luofanzhi/NB_DATA_COLLECT/README.md

# NB_DATA_COLLECT
NB-IOT水表收集器

## git使用指南

### 第一次初始化项目

```bash
git clone 项目地址
```

### 提交代码

```bash
# 拉取GitHub上最新的代码信息
git pull

# 选中本地修改的文件
git add .

# 提交变动到本地
git commit -m "注释信息"

# 推送到服务器
git push
```
