luofanzhi/NB_DATA_COLLECT/附件材料.docx

毕业设计（论文）附件材料

基于蓝牙和NB-IOT的数据采集器设计

学生姓名： 罗范支

学 号： 201610213116

所在系部： 电气信息系

专业班级： 16 gb电气3班

指导教师： 李 群 教授（职称）

日 期： 二O二O年5月

# 目 录

# 图表目录

# 第1章 程序源码

## main.c

#include "Systerm_Init.h"

#include "stm32f10x_it.h"

#include "oled.h"

#include "stdlib.h"

#include "delay.h"

#include "beep.h"

#define Scan_min(n) 60000*n //定时扫描事件

int main(void)

{

SystemInit(); //系统时钟初始化

SYSTERM_INIT(); //系统初始化

OLED_Init(); //OLED初始化

OLED_ColorTurn(0); //0正常显示，1- 反色显示

OLED_DisplayTurn(0); //0正常显示，1-屏幕翻转显示

OLED_Clear(); //清屏

BLUE_POWER_OPEN(); //打开蓝牙电源

Deveice_Display(); //设备信息显示

BlueConnectStruct.Connect=0;

while(1)

{

NB_INIT(); //上电初始化NB，储存EMI号和信号强度

KEY_Set_Blue_S_Mode(); //短按按键蓝牙切换成从模式和APP通讯

APP_To_BlueScan(Scan_min(5)); //APP启动扫描, 计时扫描单位：分钟

Determine_Deveice(); //APP通讯错误信息返回

JZQ_Write_NAME_MAC(); //APP写表号

NB_UPDATE_DATA(); //NB上传表数据--最大上传40个蓝牙水表

//Wake_Deal(); //定时唤醒处理

if(BlueConnectStruct.Connect==1)

{

if(BLUE_CONNECT_COND==0)

{

OLED_Display_GB2312_string(1,6,"蓝牙等待连接...");

}

if(BLUE_CONNECT_COND==1)

{

OLED_Display_GB2312_string(1,6,"蓝牙已连接！！！");

BlueConnectStruct.Connect=2;

}

}

else if(BlueConnectStruct.Connect==2)

{

if(BLUE_CONNECT_COND==0)

{

BlueConnectStruct.Connect=1;

}

}

}

}

## Systerm_Init.c

#include "Systerm_Init.h"

#include "beep.h"

#include "oled.h"

void SYSTERM_INIT(void)

{

NVIC_PriorityGroupConfig(NVIC_PriorityGroup_2); //中断优先级分组

USART1_Init(9600); //NB的串口

USART2_Init(115200); //蓝牙串口

USART3_Init(115200); //DEBUG串口

TIM3_Init(99,4799);//10K的计数频率，重装值为100

TIM4_Init(99,479);//1ms

delay_init();

LED_GPIO_Init();

KEY_GPIO_Init();

NB_GPIO_Init();

BLUE_GPIO_Init();

LED_Init();

NB_ALL_Flag_Init();

//IWDG_Init(6,28125);//独立看门狗初始化-预分频系数为64，重载值为625，溢出时间为1S //(4*2^5)*31250/40 ms

RTC_Init();

RTC_NVIC_Config();

ConnectBlueStruct.Connect_quality=20;//连接表端的结点数

Read_NAME_AND_NAME();//读取缓存的表号和MAC地址

BEEP_GPIO_Init();

PrintfFlag=1;

ReceivMAC_Flag=0;

}

void LED_Init(void)

{

LEDn_ON(4);

delay_ms(1000);

LEDn_OFF(4);

}

void NB_ALL_Flag_Init(void)

{

NB_Flag_Init();

Blue_Flag_Init();

BlueConnectStruct.BlueConnect_time=0;

BlueDataRceiveModeStruct.DataMode.Start_NB=0;

NB_AT_Num=0;

BlueDataRceiveModeStruct.Blue_AT_Mode=0;

BlueDataRceiveModeStruct.Blue_Data_Mode=0;

ConnectBlueStruct.Connect_Number=0;

ConnectBlueStruct.ReadBlueData_Success=0;

BlueDataRceiveModeStruct.DataMode.BlueDataCount=0;

ConnectBlueStruct.StopScan=0;

ConnectBlueStruct.Connect_OverTime_Flag=0;

ConnectBlueStruct.ReadBlueData_fail=0;

FLASH_Struct.Write_Success=0;

k=0;

Sleep_Mode_Struct.Enter_SleepMode_Flag=0;

Sleep_Mode_Struct.WeakUP=0;

BlueDataRceiveModeStruct.Blue_To_APP=0;

CommunicationStruct.Communication_RX_Cont=0;

CommunicationStruct.APP_To_JQZ_CB_Flag=0;

NB_Struct.NB_Init=0;

Work_Struct.Mode_type.JQZ_Mode.Update=0;

Work_Struct.Mode_type.Weakup.Set_ARM_Time=0;

Work_Struct.Mode_type.Weakup.WeakUP_Over_Time=0;

Work_Struct.Mode_type.Sleep_Mode=0;

Work_Struct.Mode_type.Blue_S.Con_over_Time=0;

CommunicationStruct.APP_To_JQZ_CB_Flag=0;

CommunicationStruct.JQZ_CB_UPDATE=0;

NB_Struct.NB_1=1;

NB_Struct.Net_time=0;

}

void Deveice_Display(void)

{

OLED_Display_GB2312_string(1,0,"湖北工业大学");

OLED_Display_GB2312_string(1,2,"工程技术学院");

OLED_Display_GB2312_string(1,4,"姓名：罗范支");

OLED_Display_GB2312_string(1,6,"学号201610213116");

delay_s(2);

OLED_Clear();

OLED_Display_GB2312_string(1,0,"毕业设计题目：");

OLED_Display_GB2312_string(1,2,"基于蓝牙和NB模组");

OLED_Display_GB2312_string(1,4,"的数据收集器");

OLED_Display_GB2312_string(1,6,"指导老师：李群");

delay_s(2);

OLED_Clear();

OLED_Display_GB2312_string(1,0,"系统初始化...");

BEEP_ON(1);

}

## NB.c

#include "NB.h"

#include "usart.h"

#include "string.h"

#include "led.h"

#include "BlueData_Deal.h"

#include "SimplePrintf.h"

#include "delay.h"

#include "communication_to_app.h"

#include "flash.h"

#include "wakeup.h"

#include "oled.h"

#include "beep.h"

u16 NB_time;

u8 NB_SendData_flag;

u8 NB_ReceveData_flag;

u8 NB_AT_Num;

u8 NB_ReceveData_Failed_Flag;

u16 NB_Close_Power_time;

NB_Typedef NB_Struct;

char Device_information_char_Buff[50];

uint8_t Device_information_u8_Buff[50];

//NB模组IO口初始化

void NB_GPIO_Init(void)

{

GPIO_InitTypeDef GPIO_InitStructure;

RCC_APB2PeriphClockCmd(RCC_APB2Periph_GPIOA,ENABLE);

GPIO_InitStructure.GPIO_Mode =GPIO_Mode_Out_PP;

GPIO_InitStructure.GPIO_Pin =GPIO_Pin_8|GPIO_Pin_12;

GPIO_InitStructure.GPIO_Speed = GPIO_Speed_2MHz;

GPIO_Init(GPIOA,&GPIO_InitStructure);

GPIO_ResetBits(GPIOA,GPIO_Pin_8|GPIO_Pin_12);

//GPIO_SetBits

//GPIO_ResetBits

}

void NB_NO_Rest()

{

NB_Switch=0;

}

void NB_Rest()

{

NB_Switch=1;

}

#include "time.h"

u8 CurrentTim[6];//年，月，日，时，分。各一个字节

struct tm GTM_Time;

void GTM_ConversionUTC(uint16_t Count)

{

static u32 TimSec;

GTM_Time.tm_year = 2000+CurrentTim[0]-1900;//年

GTM_Time.tm_mon = CurrentTim[1]-1;//月

GTM_Time.tm_mday = CurrentTim[2];//日

GTM_Time.tm_hour = CurrentTim[3];//时

GTM_Time.tm_min = CurrentTim[4];//分

GTM_Time.tm_sec = CurrentTim[5];//秒

TimSec = mktime(&GTM_Time);

TimSec += Count;

localtime_r(&TimSec, &GTM_Time);

CurrentTim[0] = GTM_Time.tm_year+1900-2000 ;//年

CurrentTim[1]= GTM_Time.tm_mon+1 ;//月

CurrentTim[2]= GTM_Time.tm_mday ;//日

CurrentTim[3] = GTM_Time.tm_hour ;//时

CurrentTim[4]= GTM_Time.tm_min ;//分

CurrentTim[5] = GTM_Time.tm_sec ;//秒

}

/************************NB上传数据函数*********************************/

void NB_Update_Data(void)

{

char cmd[129];

strcpy(cmd, "AT+NMGS=59,");

strcat(cmd,BlueDataRceiveModeStruct.DataMode.BlueDataStringBuff);

memset(BlueDataRceiveModeStruct.DataMode.BlueDataStringBuff,0,sizeof(BlueDataRceiveModeStruct.DataMode.BlueDataStringBuff));

memset(BlueDataRceiveModeStruct.DataMode.BlueDataStringBuff,0,sizeof(BlueDataRceiveModeStruct.DataMode.BlueDataStringBuff));

Uart1_SendAtCommand(cmd);

}

void NB_Flag_Init(void)

{

NB_AT_Num =0;

NB_SendData_flag =1;

NB_ReceveData_flag=1;

NB_Close_Power_time=0;

}

uint8_t NB_Bard_AT_Send(u8 a)

{

uint8_t m,n;

static char temp[12];

static char i;

static char IP[40];

STMFLASH_Read(FLASH_SAVE_ADDR+2048,(u16*)CommunicationStruct.IP_COM_u8,20);

HEXArrayToStringArray((u8*)CommunicationStruct.IP_COM_u8,CommunicationStruct.IP_COM_char,20);

StringArrayToHEXArray(CommunicationStruct.IP_COM_char,CommunicationStruct.IP_COM_string,40);

strcpy(IP,"AT+NCDP=");

for(i=0;i<15;i++){IP[i+8]=CommunicationStruct.IP_COM_string[i+5];}

IP[23]=CommunicationStruct.IP_COM_string[4];

IP[24]=CommunicationStruct.IP_COM_string[0];

IP[25]=CommunicationStruct.IP_COM_string[1];

IP[26]=CommunicationStruct.IP_COM_string[2];

IP[27]=CommunicationStruct.IP_COM_string[3];

if(NB_SendData_flag)

{

NB_SendData_flag=0;

switch(NB_AT_Num)

{

case 0: NB_Power_Control=1;// 1-开启NB电源，0-关闭NB电源

//NB_Rest();

NB_time=50;

break;

case 1: USart_CLR_RecvBuf(1);

Uart1_SendAtCommand("AT");//测试AT命令

NB_time=50;

break;

case 2:

if(strstr(USART1_RX_Buff,"")!=NULL)

{

USart_CLR_RecvBuf(1);

NB_ReceveData_Failed_Flag=0;

Uart1_SendAtCommand("AT+NCDP=180.101.147.115,5683");//设置IoT平台IP地址

//Uart1_SendAtCommand(IP);//设置IoT平台IP地址

NB_time=50;

}

break;

case 3:

if(strstr(USART1_RX_Buff,"")!=NULL)

{

USart_CLR_RecvBuf(1);

Uart1_SendAtCommand("AT+CGMR");//查询固件版本

NB_time=50;

}

break;

case 4: if(strstr(USART1_RX_Buff,"")!=NULL)//SECURITY

{

USart_CLR_RecvBuf(1);

Uart1_SendAtCommand("AT+CGSN=1");//查询IMEI号

NB_time=100;

}

break;

case 5: if(strstr(USART1_RX_Buff,"+CGSN:")!=NULL)

{

for(m=0;m<50;m++)

{

if(USART1_RX_Buff[m-2]=='N'&&USART1_RX_Buff[m-1]==':')

{

for(n=0;n<15;n++){Device_information_char_Buff[n]=USART1_RX_Buff[n+m];}

Device_information_char_Buff[15]='0';

}

}

USart_CLR_RecvBuf(1);

Uart1_SendAtCommand("AT+NCONFIG?");//配置自动联网，扰码开启

NB_time=50;

}

else

{

USart_CLR_RecvBuf(1);

Uart1_SendAtCommand("AT+CGSN=1");//查询IMEI号

NB_AT_Num=4;

}

break;

case 6: if(strstr(USART1_RX_Buff,"+NCONFIG:AUTOCONNECT,TRUE")!=NULL)

{

USart_CLR_RecvBuf(1);

Uart1_SendAtCommand("AT+NBAND?");

NB_time=50;

}

case 7: if(strstr(USART1_RX_Buff, "+NBAND:5") != NULL)

{

NB_ReceveData_Failed_Flag=0;

USart_CLR_RecvBuf(1);

Uart1_SendAtCommand("AT+CFUN=1");

NB_time=50;

}

break;

case 8: if(strstr(USART1_RX_Buff,"OK")!=NULL)

{

NB_ReceveData_Failed_Flag=0;

USart_CLR_RecvBuf(1);

Uart1_SendAtCommand("AT+CGATT?");

NB_time=50;

}

break;

//

case 9: if(strstr(USART1_RX_Buff,"+CGATT:1")!=NULL)

{

NB_ReceveData_Failed_Flag=0;

NB_ReceveData_Failed_Flag=0;

USart_CLR_RecvBuf(1);

Uart1_SendAtCommand("AT+CIMI");

NB_time=50;

}

else

{

USart_CLR_RecvBuf(1);

Uart1_SendAtCommand("AT+CGATT?");

NB_AT_Num=8;

NB_ReceveData_Failed_Flag++;

if(NB_ReceveData_Failed_Flag>30)

{

if(NB_Struct.Net_time==1)

{

OLED_Display_GB2312_string(1,0,"SIM卡驻网失败！");

OLED_Display_GB2312_string(1,2,"请检查SIM卡！");

OLED_Display_GB2312_string(1,4,"确认无误后请重启");

NB_AT_Num=20;

break;

}

if(NB_Struct.Net_time<1)

{

NB_Struct.Net_time+=1;

NB_Flag_Init();

NB_Power_Control=0;

delay_ms(500);

NB_AT_Num=0;

}

// Work_Struct.Mode_type.Sleep_Mode=1;

// USart_CLR_RecvBuf(1);

// Uart1_SendAtCommand("AT+CIMI");

// NB_AT_Num=9;

NB_ReceveData_Failed_Flag=0;

}

}

break;

//

case 10:

if(strstr(USART1_RX_Buff,"460")!=NULL)

{

NB_ReceveData_Failed_Flag=0;

USart_CLR_RecvBuf(1);

Uart1_SendAtCommand("AT+NCCID");

NB_time=20;

}

break;

//

case 11: if(strstr(USART1_RX_Buff,"+NCCID")!=NULL)

{

USart_CLR_RecvBuf(1);

Uart1_SendAtCommand("AT+CSQ");

NB_time=50;

}

break;

//

case 12: if(strstr(USART1_RX_Buff,"+CSQ:")!=NULL)

{

for(m=0;m<20;m++)

{

if(USART1_RX_Buff[m-2]=='Q'&&USART1_RX_Buff[m-1]==':')

{

if(USART1_RX_Buff[m+1]!=',')

{

Device_information_char_Buff[16]=USART1_RX_Buff[m];

Device_information_char_Buff[17]=USART1_RX_Buff[m+1];

}

else if(USART1_RX_Buff[m+1]==',')

{

Device_information_char_Buff[16]='0';

Device_information_char_Buff[17]=USART1_RX_Buff[m];

}

}

}

USart_CLR_RecvBuf(1);

Uart1_SendAtCommand("AT+CEREG?");

NB_time=5;

}

break;

//

case 13: if(strstr(USART1_RX_Buff, "+CEREG:0,1") != NULL)

{

USart_CLR_RecvBuf(1);

Uart1_SendAtCommand("AT+CSCON?");

NB_ReceveData_Failed_Flag=0;

NB_time=50;

}

else

{

NB_AT_Num=12;

NB_ReceveData_Failed_Flag++;

Uart1_SendAtCommand("AT+CEREG?");

NB_time=50;

}

break;

//

case 14: if(strstr(USART1_RX_Buff, "+CSCON:0,1") != NULL)

{

NB_ReceveData_Failed_Flag=0;

USart_CLR_RecvBuf(1);

Uart1_SendAtCommand("AT+CCLK?");

NB_time=50;

}

else

{

NB_AT_Num=13;

USart_CLR_RecvBuf(1);

Uart1_SendAtCommand("AT+CSCON?");

NB_time=50;

NB_ReceveData_Failed_Flag++;

if(NB_ReceveData_Failed_Flag>100)

{

Work_Struct.Mode_type.Sleep_Mode=1;

NB_ReceveData_Failed_Flag=0;

}

}

break;

case 15: if(strstr(USART1_RX_Buff, "+CCLK:") != NULL)

{

temp[0]=USART1_RX_Buff[8];//年

temp[1]=USART1_RX_Buff[9];

temp[2]=USART1_RX_Buff[11];//月

temp[3]=USART1_RX_Buff[12];

temp[4]=USART1_RX_Buff[14];//日

temp[5]=USART1_RX_Buff[15];

temp[6]=USART1_RX_Buff[17];//时

temp[7]=USART1_RX_Buff[18];

temp[8]=USART1_RX_Buff[20];//分

temp[9]=USART1_RX_Buff[21];

temp[10]=USART1_RX_Buff[23];//秒

temp[11]=USART1_RX_Buff[24];

AscillToString(temp, temp,12);//Ascii转16进制

for(i=0;i<6;i++)

CurrentTim[i] = temp[i*2]*10+temp[i*2+1];//数组高低位合并

GTM_ConversionUTC(28800);//3600*8小时

USart_CLR_RecvBuf(1);

Uart1_SendAtCommand("AT+NNMI=0");

NB_time=100;

}

break;

case 16: if(strstr(USART1_RX_Buff, "OK") != NULL)

{

if(a==1)

{

STMFLASH_Write(FLASH_SAVE_ADDR+4096,(u16*)Device_information_char_Buff,18);

NB_Struct.NB_Init=1;

ConnectBlueStruct.Read_Flag=0;

USart_CLR_RecvBuf(1);

NB_time=100;

USART3_Send_Arr(Device_information_char_Buff,18);

OLED_Clear();

OLED_Display_GB2312_string(1,0,"系统初始化成功!!");

OLED_Display_GB2312_string(1,4,"长按按键启动蓝牙");

BEEP_ON(3);

}

else if(a==2)

{

STMFLASH_Write(FLASH_SAVE_ADDR+4096,(u16*)Device_information_char_Buff,18);

ConnectBlueStruct.Read_Flag=0;

ConnectBlueStruct.BlueScanSuccess=1;

ConnectBlueStruct.connect_flag=1;

CommunicationStruct.APP_To_JQZ_CB_Flag=0;

USart_CLR_RecvBuf(1);

NB_time=100;

}

//NB_Update_Data();

}

break;

default : NB_time=0;

NB_AT_Num=0;

NB_SendData_flag=0;

NB_ReceveData_flag=0;

break;

}

}

return NB_ReceveData_Failed_Flag;

}

void NB_Iot_AT_Send(u8 b)

{

if(NB_SendData_flag)

{

if(NB_ReceveData_flag)//

{

NB_ReceveData_flag=0;

NB_Bard_AT_Send(b);

}

}

}

void NB_INIT(void)

{

if(ConnectBlueStruct.Read_Flag)//启动NB

{

NB_Struct.Mode =1;

NB_Iot_AT_Send(1);

}

}

void NB_UPDATE_DATA(void)//NB上传数据

{

u8 i;

char name[142];

char mac[122];

if(CommunicationStruct.APP_To_JQZ_CB_Flag==0x01)

{

NB_Struct.Mode=1;

Uart2_SendAtCommand("AT+DISCONNECT");

delay_ms(200);

Uart2_SendAtCommand("AT+ROLE=M");

STMFLASH_Read(SAVE_ADDR_NAME_1,(u16*)name,70);

STMFLASH_Read(SAVE_ADDR_MAC_1,(u16*)mac,60);

for(i=0;i<140;i++){BlueNAME[i]=name[i];}

for(i=0;i<120;i++){BlueMAC[i]=mac[i];}

ConnectBlueStruct.Connect_lenth =strlen(BlueNAME)/14*2;

StringToBytes(BlueNAME,StringConvert16_BlueNAME,140);//蓝牙名称字符串转16进制

NB_Flag_Init();

NB_Power_Control=0;

delay_ms(1000);

NB_Power_Control=1;

CommunicationStruct.APP_To_JQZ_CB_Flag++;

}

if(CommunicationStruct.JQZ_CB_UPDATE==0x01&&CommunicationStruct.APP_To_JQZ_CB_Flag==0x02)

{

//LED3=!LED3;

NB_Struct.Mode =1;

NB_Iot_AT_Send(2);

}

if(Work_Struct.Mode_type.JQZ_Mode.Update==1)//第二次上传10个

{

STMFLASH_Read(SAVE_ADDR_NAME_2,(u16*)name,70);

STMFLASH_Read(SAVE_ADDR_MAC_2,(u16*)mac,60);

for(i=0;i<140;i++){BlueNAME[i]=name[i];}

for(i=0;i<120;i++){BlueMAC[i]=mac[i];}

ConnectBlueStruct.Connect_lenth =strlen(BlueNAME)/14*2;

if(ConnectBlueStruct.Connect_lenth<10||(BlueMAC[60]=='0'&&BlueMAC[61]=='0'&&BlueMAC[62]=='0'&&BlueMAC[63]=='0'))

{

ConnectBlueStruct.BlueScanSuccess=0;

ConnectBlueStruct.connect_flag=0;

delay_ms(100);

raw_printf("抄表结束");

Work_Struct.Mode_type.JQZ_Mode.Update=0;

}

else

{

StringToBytes(BlueNAME,StringConvert16_BlueNAME,140);//蓝牙名称字符串转16进制

ConnectBlueStruct.BlueScanSuccess=1;

ConnectBlueStruct.connect_flag=1;

Work_Struct.Mode_type.JQZ_Mode.Update++;

}

}

if(Work_Struct.Mode_type.JQZ_Mode.Update==3)//第三次上传10个

{

STMFLASH_Read(SAVE_ADDR_NAME_3,(u16*)name,70);

STMFLASH_Read(SAVE_ADDR_MAC_3,(u16*)mac,60);

for(i=0;i<140;i++){BlueNAME[i]=name[i];}

for(i=0;i<120;i++){BlueMAC[i]=mac[i];}

ConnectBlueStruct.Connect_lenth =strlen(BlueNAME)/14*2;

if(ConnectBlueStruct.Connect_lenth<10||(BlueMAC[60]=='0'&&BlueMAC[61]=='0'&&BlueMAC[62]=='0'&&BlueMAC[63]=='0'))

{

ConnectBlueStruct.BlueScanSuccess=0;

ConnectBlueStruct.connect_flag=0;

delay_ms(100);

raw_printf("抄表结束");

Work_Struct.Mode_type.JQZ_Mode.Update=0;

}

else

{

StringToBytes(BlueNAME,StringConvert16_BlueNAME,140);//蓝牙名称字符串转16进制

ConnectBlueStruct.BlueScanSuccess=1;

ConnectBlueStruct.connect_flag=1;

Work_Struct.Mode_type.JQZ_Mode.Update++;

}

}

if(Work_Struct.Mode_type.JQZ_Mode.Update==5)//第四次上传10个

{

STMFLASH_Read(SAVE_ADDR_NAME_4,(u16*)name,70);

STMFLASH_Read(SAVE_ADDR_MAC_4,(u16*)mac,60);

for(i=0;i<140;i++){BlueNAME[i]=name[i];}

for(i=0;i<120;i++){BlueMAC[i]=mac[i];}

ConnectBlueStruct.Connect_lenth =strlen(BlueNAME)/14*2;//实际表节点数

if(ConnectBlueStruct.Connect_lenth<10||(BlueMAC[60]=='0'&&BlueMAC[61]=='0'&&BlueMAC[62]=='0'&&BlueMAC[63]=='0'))

{

ConnectBlueStruct.BlueScanSuccess=0;

ConnectBlueStruct.connect_flag=0;

delay_ms(100);

raw_printf("抄表结束");

Work_Struct.Mode_type.JQZ_Mode.Update=0;

}

else

{

StringToBytes(BlueNAME,StringConvert16_BlueNAME,140);//蓝牙名称字符串转16进制

ConnectBlueStruct.BlueScanSuccess=1;

ConnectBlueStruct.connect_flag=1;

Work_Struct.Mode_type.JQZ_Mode.Update++;

}

}

if(Work_Struct.Mode_type.JQZ_Mode.Update==7)

{

ConnectBlueStruct.BlueScanSuccess=0;

ConnectBlueStruct.connect_flag=0;

delay_ms(100);

raw_printf("抄表结束");

Work_Struct.Mode_type.JQZ_Mode.Update=0;

}

if(ConnectBlueStruct.connect_flag)//读表数据并上传

{

BLUE_POWER_OPEN();

BLUE_EN_ENABLE();

Connect_Blue_Read_Data(ConnectBlueStruct.Connect_quality);

Connect_Fail_Deal();//第一次读表数据失败的进行第二次读表数据

}

}

## led.c

#include "led.h"

#include "sys.h"

void LED_GPIO_Init(void)

{

GPIO_InitTypeDef GPIO_InitStructure;

RCC_APB2PeriphClockCmd(RCC_APB2Periph_GPIOB,ENABLE);

GPIO_InitStructure.GPIO_Mode =GPIO_Mode_Out_PP;

GPIO_InitStructure.GPIO_Pin =GPIO_Pin_12|GPIO_Pin_13|GPIO_Pin_14;

GPIO_InitStructure.GPIO_Speed = GPIO_Speed_2MHz;

GPIO_Init(GPIOB,&GPIO_InitStructure);

GPIO_SetBits(GPIOB,GPIO_Pin_12|GPIO_Pin_13|GPIO_Pin_14);

}

void LEDn_ON(u8 num)

{

switch(num)

{

case 1:LED1=0;

break;

case 2:LED2=0;

break;

case 3:LED3=0;

break;

case 4:LED1=0;LED2=0;LED3=0;

break;

default:

break;

}

}

void LEDn_OFF(u8 num)

{

switch(num)

{

case 1:LED1=1;

break;

case 2:LED2=1;

break;

case 3:LED3=1;

break;

case 4:LED1=1;LED2=1;LED3=1;

break;

default:

break;

}

}

## key.c

#include "key.h"

#include "sys.h"

#include "delay.h"

#include "BlueData_Deal.h"

#include "usart.h"

#include "led.h"

#include "BlueTooth.h"

#define StartScan 1

KEYTypedef KEYStruct;

void KEY_GPIO_Init(void)

{

GPIO_InitTypeDef GPIO_InitStructure;

RCC_APB2PeriphClockCmd(RCC_APB2Periph_GPIOA, ENABLE); // led4

GPIO_InitStructure.GPIO_Pin =GPIO_Pin_0; //

GPIO_InitStructure.GPIO_Mode = GPIO_Mode_IPU; //

GPIO_InitStructure.GPIO_Speed = GPIO_Speed_2MHz; //

GPIO_Init(GPIOA,&GPIO_InitStructure);

}

u8 KEY_Scan(u8 mode)//mode-1-支持连按

{

static u8 key_up=1;//按键松开标志

if(mode)key_up=1;//支持连按

if(key_up&&(KEY1==0||KEY2==0||KEY3==0))

{

delay_ms(5);

key_up=0;

if(KEY1==0)return 1;

else if(KEY2==0)return 2;

else if(KEY3==0)return 3;

}

else if(KEY1==1&&KEY2==1&&KEY3==1)key_up=1;

return 0;//无按键按下

}

void KEY_SCAN(uint8_t Jishi_Time)//计时单位为：分钟

{

if(KEY_Scan(1)==2)

{

KEYStruct.KEY_MODE.short_key=1;

KEYStruct.KEY_Time++;

if(KEYStruct.KEY_Time>50)

{

BLUE_POWER_OPEN();

BLUE_EN_ENABLE();

BlueDataRceiveModeStruct.Blue_AT_Mode=2;

ConnectBlueStruct.ConnectBlueReceive_AT=1;;//串口接收切换成扫描模式

ConnectBlueStruct.ScanTime=Jishi_Time*60000;

KEYStruct.KEY_MODE.long_key=1;

Uart2_SendAtCommand("AT+ROLE=M");

delay_ms(200);

Uart2_SendAtCommand("AT+SCAN:RSSI=-80");

KEYStruct.KEY_Time=600;

}

else

{

KEYStruct.KEY_MODE.short_key=1;

}

}

if(StartScan==1&&KEYStruct.KEY_MODE.long_key==1)

{

LED1=0;

Take_Out_NAME_MAC(80);

if(ConnectBlueStruct.StopScan)

{

KEYStruct.KEY2_Flag=0;

ConnectBlueStruct.StopScan=0;

USart_CLR_RecvBuf(2);

#undef StartScan

}

}

}

## NB_time.c

#include "NB_time.h"

#include "sys.h"

#include "NB.h"

#include "led.h"

#include "BlueTooth.h"

#include "BlueData_Deal.h"

#include "Blue_time.h"

#include "BlueTooth.h"

//通用定时器3中断初始化

//这里时钟选择为APB1的2倍，而APB1为36M

//arr：自动重装值。

//psc：时钟预分频数

//这里使用的是定时器3!

void TIM3_Init(u16 arr,u16 psc)

{

TIM_TimeBaseInitTypeDef TIM_TimeBaseStructure;

NVIC_InitTypeDef NVIC_InitStructure;

RCC_APB1PeriphClockCmd(RCC_APB1Periph_TIM3, ENABLE); //时钟使能

//定时器TIM3初始化

TIM_TimeBaseStructure.TIM_Period = arr; //设置在下一个更新事件装入活动的自动重装载寄存器周期的值

TIM_TimeBaseStructure.TIM_Prescaler =psc; //设置用来作为TIMx时钟频率除数的预分频值

TIM_TimeBaseStructure.TIM_ClockDivision = TIM_CKD_DIV1; //设置时钟分割:TDTS = Tck_tim

TIM_TimeBaseStructure.TIM_CounterMode = TIM_CounterMode_Down; //TIM向下计数模式

TIM_TimeBaseInit(TIM3, &TIM_TimeBaseStructure); //根据指定的参数初始化TIMx的时间基数单位

TIM_ITConfig(TIM3,TIM_IT_Update,ENABLE ); //使能指定的TIM3中断,允许更新中断

//中断优先级NVIC设置

NVIC_InitStructure.NVIC_IRQChannel = TIM3_IRQn; //TIM3中断

NVIC_InitStructure.NVIC_IRQChannelPreemptionPriority = 0; //先占优先级0级

NVIC_InitStructure.NVIC_IRQChannelSubPriority = 2; //从优先级3级

NVIC_InitStructure.NVIC_IRQChannelCmd = ENABLE; //IRQ通道被使能

NVIC_Init(&NVIC_InitStructure); //初始化NVIC寄存器

TIM_Cmd(TIM3, ENABLE); //使能TIMx

}

//定时器3中断服务程序

void TIM3_IRQHandler(void) //TIM3中断

{

if (TIM_GetITStatus(TIM3, TIM_IT_Update) != RESET) //检查TIM3更新中断发生与否

{

TIM_ClearITPendingBit(TIM3, TIM_IT_Update ); //清除TIMx更新中断标志

if(NB_time>0)

{

NB_time--;

if(NB_time==0)

{

NB_AT_Num++;

//LED1=!LED1;

NB_SendData_flag=1;

NB_ReceveData_flag=1;

}

}

if(NB_Close_Power_time>0)

{

NB_Close_Power_time--;

if(NB_Close_Power_time==0)

{

NB_Power_Control=0;

LEDn_OFF(1);

LEDn_OFF(2);

LEDn_OFF(3);

}

}

if(Blue_time >0)

{

Blue_time--;

if(Blue_time ==0)

{

Blue_AT_num ++;

Blue_ReceveData_Flag=1;

Blue_SendData_Flag =1;

}

}

if(ConnectBlueStruct.Connect_Time>0)

{

ConnectBlueStruct.Connect_Time--;

if(ConnectBlueStruct.Connect_Time==0)

{

ConnectBlueStruct.Connect_OverTime_Flag=1;

}

}

}

}

## wdg.c

#include "wdg.h"

//初始化独立看门狗

//prer:分频数:0~7(只有低3位有效!)

//分频因子=4*2^prer.但最大值只能是256!

//rlr:重装载寄存器值:低11位有效.

//时间计算(大概):Tout=((4*2^prer)*rlr)/40 (ms).

void IWDG_Init(u8 prer,u16 rlr)

{

IWDG_WriteAccessCmd(IWDG_WriteAccess_Enable); //使能对寄存器IWDG_PR和IWDG_RLR的写操作

IWDG_SetPrescaler(prer); //设置IWDG预分频值:设置IWDG预分频值为64

IWDG_SetReload(rlr); //设置IWDG重装载值

IWDG_ReloadCounter(); //按照IWDG重装载寄存器的值重装载IWDG计数器

IWDG_Enable(); //使能IWDG

}

//喂独立看门狗

void IWDG_Feed(void)

{

IWDG_ReloadCounter();//reload

}

## BlueTooth.c

#include "BlueTooth.h"

#include <string.h>

#include "usart.h"

#include "SimplePrintf.h"

#include "stdio.h"

#include "stdlib.h"

#include "Blue_time.h"

#include "BlueData_Deal.h"

#include "delay.h"

#include "communication_to_app.h"

#include "key.h"

#include "wakeup.h"

#include "oled.h"

u16 Blue_time;

u8 Blue_SendData_Flag;

u8 Blue_ReceveData_Flag;

u8 Blue_AT_num;

u8 Blue_ReceveData_fail_Flag;

char CONNECT_MAC[12];

uint8_t CONNECT_NAME[14];

uint8_t CONNECT_NAME_uint[7];

char Tuff[100];

uint8_t BLE_TO_NB_Data[100];

BlueConnect BlueConnectStruct;

void BLUE_GPIO_Init(void)

{

GPIO_InitTypeDef GPIO_InitStructure;

RCC_APB2PeriphClockCmd(RCC_APB2Periph_GPIOA|RCC_APB2Periph_GPIOC, ENABLE); // led4

GPIO_InitStructure.GPIO_Pin =GPIO_Pin_1; //

GPIO_InitStructure.GPIO_Mode = GPIO_Mode_Out_PP; //

GPIO_InitStructure.GPIO_Speed = GPIO_Speed_2MHz; //

GPIO_Init(GPIOA,&GPIO_InitStructure);

GPIO_ResetBits(GPIOA,GPIO_Pin_1);//蓝牙的电源控制引脚

GPIO_InitStructure.GPIO_Pin =GPIO_Pin_5|GPIO_Pin_7; //

GPIO_InitStructure.GPIO_Mode = GPIO_Mode_Out_PP; //

GPIO_InitStructure.GPIO_Speed = GPIO_Speed_2MHz; //

GPIO_Init(GPIOA,&GPIO_InitStructure);

GPIO_ResetBits(GPIOA,GPIO_Pin_1|GPIO_Pin_3); //PC1为蓝牙的使能引脚***PC3为蓝牙的复位引脚

GPIO_InitStructure.GPIO_Pin =GPIO_Pin_4; //

GPIO_InitStructure.GPIO_Mode = GPIO_Mode_IPD; //

GPIO_InitStructure.GPIO_Speed = GPIO_Speed_2MHz; //

GPIO_Init(GPIOA,&GPIO_InitStructure);

//蓝牙接收数据引脚/****接收到数据时为高电平，无数据时为低电平*****/

GPIO_InitStructure.GPIO_Pin =GPIO_Pin_6; //

GPIO_InitStructure.GPIO_Mode = GPIO_Mode_IPD; //

GPIO_InitStructure.GPIO_Speed = GPIO_Speed_2MHz; //

GPIO_Init(GPIOA,&GPIO_InitStructure);

//连接指示灯*****/

}

void BLUE_POWER_OPEN(void)//开启蓝牙电源

{

BLUE_POWER=1;

}

void BLUE_POWER_CLOSE(void)//关闭蓝牙电源

{

BLUE_POWER=0;

}

void BLUE_EN_ENABLE(void)//蓝牙使能

{

BLUE_EN=1;

}

void BLUE_EN_DISABLE(void)//蓝牙失能

{

BLUE_EN=0;

}

void BLUE_RST_ENABLE(void)//蓝牙复位

{

BLUE_RST=0;

}

void BLUE_RST_DISABLE(void)//蓝牙不复位

{

BLUE_RST=1;

}

void Blue_Flag_Init(void)

{

Blue_AT_num =0;

Blue_ReceveData_Flag =1;

Blue_SendData_Flag =1;

Blue_time =0;

}

void Blue_S_AT_Config(void)//从模式的AT配置

{

if(Blue_SendData_Flag ==1)

{

Blue_SendData_Flag=0;

switch (Blue_AT_num)

{

case 0: OLED_Clear();

OLED_Display_GB2312_string(1,0,"正在启动蓝牙...");

BLUE_EN_ENABLE();

raw_printf("当前蓝牙为从模式:");

Blue_time =50;

break;

case 1:

USart_CLR_RecvBuf(2);

Uart2_SendAtCommand("AT+DEFAULT");//恢复出厂设置

Blue_time =1;

break;

case 2: if(strstr(USART2_RX_Buff,"OK")!=NULL)

{

USart_CLR_RecvBuf(2);

Uart2_SendAtCommand("AT+ROLE=S");//设置为从模式

Blue_time =10;

}

else

{

USart_CLR_RecvBuf(2);

Uart2_SendAtCommand("AT+DEFAULT");//恢复出厂设置

Blue_AT_num=1;

Blue_time =10;

}

break;

case 3: if(strstr(USART2_RX_Buff,"OK")!=NULL)

{

USart_CLR_RecvBuf(2);

Uart2_SendAtCommand("AT+BAUD=115200");//设置波特率

Blue_time =10;

}

break;

case 4: if(strstr(USART2_RX_Buff,"OK")!=NULL)

{

USart_CLR_RecvBuf(2);

Uart2_SendAtCommand("AT+NAME=NB_BLUETOOTH—1");//设置蓝牙名字

Blue_time =10;

}

break;

case 5: if(strstr(USART2_RX_Buff,"OK")!=NULL)

{

USart_CLR_RecvBuf(2);

Uart2_SendAtCommand("AT+RFPM=5");//设置蓝牙发送功率

Blue_time =10;

}

break;

case 6: if(strstr(USART2_RX_Buff,"OK")!=NULL)

{

USart_CLR_RecvBuf(2);

Uart2_SendAtCommand("AT+MODE=0");//设置模式

Blue_time =10;

}

break;

case 7: if(strstr(USART2_RX_Buff,"OK")!=NULL)

{

USart_CLR_RecvBuf(2);

Uart2_SendAtCommand("AT+RX");//查询蓝牙模块参数

Blue_time =10;

BlueDataRceiveModeStruct.Blue_AT_Mode=0;

ConnectBlueStruct.ConnectBlueReceive_AT=0;

BlueDataRceiveModeStruct.Blue_To_APP=1;

Work_Struct.Mode_type.Blue_S.Con_Time=240000L;

}

break;

case 8:

Blue_Flag_Init();

KEYStruct.KEY_Time=0;

CommunicationStruct.S_Mode_Start =0;

KEYStruct.KEY_S_Mode_Time=0;

LEDn_ON(1);

OLED_Clear();

OLED_Display_GB2312_string(1,0,"蓝牙已启动！");

OLED_Display_GB2312_string(1,2,"蓝牙名称：");

OLED_Display_GB2312_string(1,4,"NB_BLUETOOTH—1");

BlueConnectStruct.Connect=1;

break;

default: Blue_time=0;

Blue_AT_num=0;

break;

}

}

}

//数字转字符串

void itoi(char *str, unsigned long num)

{

char index[]="0123456789";

char i = 0, j = 0,temp;

do

{

str[i++] = index[num%10];

num /= 10;

}while(num);

str[i]='\0';

for(j=0; j<=(i-1)/2; j++)

{

temp=str[j];

str[j]=str[i-j-1];

str[i-j-1]=temp;

}

}

void BlueTooth_S_AT_Send(void)

{

if(Blue_SendData_Flag&&Blue_ReceveData_Flag)

{

Blue_ReceveData_Flag=0;

Blue_S_AT_Config();

}

}

void BLE_StopScan_Set(void)//停止扫描

{

// USart_CLR_RecvBuf(2);

Uart2_SendAtCommand("AT+STOPSCAN");//

}

void BLE_CLRBOND(void)

{

USart_CLR_RecvBuf(2);

Uart2_SendAtCommand("AT+CLRBOND");//取消绑定

}

u8 CheckDataSmae(char input[12],char compare[12])

{

u8 i=0,j=0,temp;

temp =12;

if(temp>1)

{

for(i=0;i<12;i++)

{

if(input[i] !=compare[i])

{

j=1;break;

}

}

}

return j;

}

## SimplePrintf.c

#include "BlueTooth.h"

#include <string.h>

#include "usart.h"

#include "SimplePrintf.h"

#include "stdio.h"

#include "stdlib.h"

#include "Blue_time.h"

#include "BlueData_Deal.h"

#include "delay.h"

#include "communication_to_app.h"

#include "key.h"

#include "wakeup.h"

#include "oled.h"

u16 Blue_time;

u8 Blue_SendData_Flag;

u8 Blue_ReceveData_Flag;

u8 Blue_AT_num;

u8 Blue_ReceveData_fail_Flag;

char CONNECT_MAC[12];

uint8_t CONNECT_NAME[14];

uint8_t CONNECT_NAME_uint[7];

char Tuff[100];

uint8_t BLE_TO_NB_Data[100];

BlueConnect BlueConnectStruct;

void BLUE_GPIO_Init(void)

{

GPIO_InitTypeDef GPIO_InitStructure;

RCC_APB2PeriphClockCmd(RCC_APB2Periph_GPIOA|RCC_APB2Periph_GPIOC, ENABLE); // led4

GPIO_InitStructure.GPIO_Pin =GPIO_Pin_1; //

GPIO_InitStructure.GPIO_Mode = GPIO_Mode_Out_PP; //

GPIO_InitStructure.GPIO_Speed = GPIO_Speed_2MHz; //

GPIO_Init(GPIOA,&GPIO_InitStructure);

GPIO_ResetBits(GPIOA,GPIO_Pin_1);//蓝牙的电源控制引脚

GPIO_InitStructure.GPIO_Pin =GPIO_Pin_5|GPIO_Pin_7; //

GPIO_InitStructure.GPIO_Mode = GPIO_Mode_Out_PP; //

GPIO_InitStructure.GPIO_Speed = GPIO_Speed_2MHz; //

GPIO_Init(GPIOA,&GPIO_InitStructure);

GPIO_ResetBits(GPIOA,GPIO_Pin_1|GPIO_Pin_3); //PC1为蓝牙的使能引脚***PC3为蓝牙的复位引脚

GPIO_InitStructure.GPIO_Pin =GPIO_Pin_4; //

GPIO_InitStructure.GPIO_Mode = GPIO_Mode_IPD; //

GPIO_InitStructure.GPIO_Speed = GPIO_Speed_2MHz; //

GPIO_Init(GPIOA,&GPIO_InitStructure);

//蓝牙接收数据引脚/****接收到数据时为高电平，无数据时为低电平*****/

GPIO_InitStructure.GPIO_Pin =GPIO_Pin_6; //

GPIO_InitStructure.GPIO_Mode = GPIO_Mode_IPD; //

GPIO_InitStructure.GPIO_Speed = GPIO_Speed_2MHz; //

GPIO_Init(GPIOA,&GPIO_InitStructure);

//连接指示灯*****/

}

void BLUE_POWER_OPEN(void)//开启蓝牙电源

{

BLUE_POWER=1;

}

void BLUE_POWER_CLOSE(void)//关闭蓝牙电源

{

BLUE_POWER=0;

}

void BLUE_EN_ENABLE(void)//蓝牙使能

{

BLUE_EN=1;

}

void BLUE_EN_DISABLE(void)//蓝牙失能

{

BLUE_EN=0;

}

void BLUE_RST_ENABLE(void)//蓝牙复位

{

BLUE_RST=0;

}

void BLUE_RST_DISABLE(void)//蓝牙不复位

{

BLUE_RST=1;

}

void Blue_Flag_Init(void)

{

Blue_AT_num =0;

Blue_ReceveData_Flag =1;

Blue_SendData_Flag =1;

Blue_time =0;

}

void Blue_S_AT_Config(void)//从模式的AT配置

{

if(Blue_SendData_Flag ==1)

{

Blue_SendData_Flag=0;

switch (Blue_AT_num)

{

case 0: OLED_Clear();

OLED_Display_GB2312_string(1,0,"正在启动蓝牙...");

BLUE_EN_ENABLE();

raw_printf("当前蓝牙为从模式:");

Blue_time =50;

break;

case 1:

USart_CLR_RecvBuf(2);

Uart2_SendAtCommand("AT+DEFAULT");//恢复出厂设置

Blue_time =1;

break;

case 2: if(strstr(USART2_RX_Buff,"OK")!=NULL)

{

USart_CLR_RecvBuf(2);

Uart2_SendAtCommand("AT+ROLE=S");//设置为从模式

Blue_time =10;

}

else

{

USart_CLR_RecvBuf(2);

Uart2_SendAtCommand("AT+DEFAULT");//恢复出厂设置

Blue_AT_num=1;

Blue_time =10;

}

break;

case 3: if(strstr(USART2_RX_Buff,"OK")!=NULL)

{

USart_CLR_RecvBuf(2);

Uart2_SendAtCommand("AT+BAUD=115200");//设置波特率

Blue_time =10;

}

break;

case 4: if(strstr(USART2_RX_Buff,"OK")!=NULL)

{

USart_CLR_RecvBuf(2);

Uart2_SendAtCommand("AT+NAME=NB_BLUETOOTH—1");//设置蓝牙名字

Blue_time =10;

}

break;

case 5: if(strstr(USART2_RX_Buff,"OK")!=NULL)

{

USart_CLR_RecvBuf(2);

Uart2_SendAtCommand("AT+RFPM=5");//设置蓝牙发送功率

Blue_time =10;

}

break;

case 6: if(strstr(USART2_RX_Buff,"OK")!=NULL)

{

USart_CLR_RecvBuf(2);

Uart2_SendAtCommand("AT+MODE=0");//设置模式

Blue_time =10;

}

break;

case 7: if(strstr(USART2_RX_Buff,"OK")!=NULL)

{

USart_CLR_RecvBuf(2);

Uart2_SendAtCommand("AT+RX");//查询蓝牙模块参数

Blue_time =10;

BlueDataRceiveModeStruct.Blue_AT_Mode=0;

ConnectBlueStruct.ConnectBlueReceive_AT=0;

BlueDataRceiveModeStruct.Blue_To_APP=1;

Work_Struct.Mode_type.Blue_S.Con_Time=240000L;

}

break;

case 8:

Blue_Flag_Init();

KEYStruct.KEY_Time=0;

CommunicationStruct.S_Mode_Start =0;

KEYStruct.KEY_S_Mode_Time=0;

LEDn_ON(1);

OLED_Clear();

OLED_Display_GB2312_string(1,0,"蓝牙已启动！");

OLED_Display_GB2312_string(1,2,"蓝牙名称：");

OLED_Display_GB2312_string(1,4,"NB_BLUETOOTH—1");

BlueConnectStruct.Connect=1;

break;

default: Blue_time=0;

Blue_AT_num=0;

break;

}

}

}

//数字转字符串

void itoi(char *str, unsigned long num)

{

char index[]="0123456789";

char i = 0, j = 0,temp;

do

{

str[i++] = index[num%10];

num /= 10;

}while(num);

str[i]='\0';

for(j=0; j<=(i-1)/2; j++)

{

temp=str[j];

str[j]=str[i-j-1];

str[i-j-1]=temp;

}

}

void BlueTooth_S_AT_Send(void)

{

if(Blue_SendData_Flag&&Blue_ReceveData_Flag)

{

Blue_ReceveData_Flag=0;

Blue_S_AT_Config();

}

}

void BLE_StopScan_Set(void)//停止扫描

{

// USart_CLR_RecvBuf(2);

Uart2_SendAtCommand("AT+STOPSCAN");//

}

void BLE_CLRBOND(void)

{

USart_CLR_RecvBuf(2);

Uart2_SendAtCommand("AT+CLRBOND");//取消绑定

}

u8 CheckDataSmae(char input[12],char compare[12])

{

u8 i=0,j=0,temp;

temp =12;

if(temp>1)

{

for(i=0;i<12;i++)

{

if(input[i] !=compare[i])

{

j=1;break;

}

}

}

return j;

}

## Blue_time.c

#include "Blue_time.h"

#include "BlueTooth.h"

#include "usart.h"

#include "BlueData_Deal.h"

#include "communication_to_app.h"

#include "SleepMode.h"

#include "wakeup.h"

//通用定时器4中断初始化

//这里时钟选择为APB1的2倍，而APB1为48M

//arr：自动重装值。

//psc：时钟预分频数

//这里使用的是定时器4!

void TIM4_Init(u16 arr,u16 psc)

{

TIM_TimeBaseInitTypeDef TIM_TimeBaseStructure;

NVIC_InitTypeDef NVIC_InitStructure;

RCC_APB1PeriphClockCmd(RCC_APB1Periph_TIM4, ENABLE); //时钟使能

//定时器TIM4初始化

TIM_TimeBaseStructure.TIM_Period = arr; //设置在下一个更新事件装入活动的自动重装载寄存器周期的值

TIM_TimeBaseStructure.TIM_Prescaler =psc; //设置用来作为TIMx时钟频率除数的预分频值

TIM_TimeBaseStructure.TIM_ClockDivision = TIM_CKD_DIV1; //设置时钟分割:TDTS = Tck_tim

TIM_TimeBaseStructure.TIM_CounterMode = TIM_CounterMode_Down; //TIM向下计数模式

TIM_TimeBaseInit(TIM4, &TIM_TimeBaseStructure); //根据指定的参数初始化TIMx的时间基数单位

TIM_Cmd(TIM4, ENABLE); //

TIM_ITConfig(TIM4,TIM_IT_Update,ENABLE ); //使能指定的TIM4中断,允许更新中断

//中断优先级NVIC设置

NVIC_InitStructure.NVIC_IRQChannel = TIM4_IRQn; //TIM4中断

NVIC_InitStructure.NVIC_IRQChannelPreemptionPriority = 0; //先占优先级0级

NVIC_InitStructure.NVIC_IRQChannelSubPriority = 2; //从优先级2级

NVIC_InitStructure.NVIC_IRQChannelCmd = ENABLE; //IRQ通道被使能

NVIC_Init(&NVIC_InitStructure); //初始化NVIC寄存器

}

void OPEN_TIME4(void)

{

TIM_Cmd(TIM4, ENABLE); //使能TIM4

}

void CLOSE_TIME4(void)

{

TIM_Cmd(TIM4, DISABLE); //失能TIM4

}

//定时器4中断服务程序

void TIM4_IRQHandler(void) //TIM4中断

{

if (TIM_GetITStatus(TIM4, TIM_IT_Update) != RESET) //检查TIM4更新中断发生与否

{

TIM_ClearITPendingBit(TIM4, TIM_IT_Update); //清除TIMx更新中断标志

if(ConnectBlueStruct.ReadData_Time>0)

{

ConnectBlueStruct.ReadData_Time--;

if(ConnectBlueStruct.ReadData_Time==0)

{

ConnectBlueStruct.ReadBlueData_fail=1;

}

}

if(ConnectBlueStruct.ScanTime>0)

{

ConnectBlueStruct.ScanTime--;

if(ConnectBlueStruct.ScanTime==0)

{

ConnectBlueStruct.Scan_OverTime_Flag=1;

}

}

if(Sleep_Mode_Struct.Enter_SleepMode_Time>0)

{

Sleep_Mode_Struct.Enter_SleepMode_Time--;

if(Sleep_Mode_Struct.Enter_SleepMode_Time==0)

{

Sleep_Mode_Struct.Enter_SleepMode_Flag=1;

}

}

if(CommunicationStruct.Receive_Time>0)

{

CommunicationStruct.Receive_Time--;

if(CommunicationStruct.Receive_Time ==0)

{

CommunicationStruct.Receive_Over_Time=1;

}

}

if(Work_Struct.Mode_type.Blue_S.Con_Time>0)

{

Work_Struct.Mode_type.Blue_S.Con_Time--;

if(Work_Struct.Mode_type.Blue_S.Con_Time==0)

{

Work_Struct.Mode_type.Blue_S.Con_over_Time=1;

}

}

}

}

## BlueData_Deal.c

#include "BlueData_Deal.h"

#include "usart.h"

#include "stdio.h"

#include "string.h"

#include "led.h"

#include "delay.h"

#include "BlueTooth.h"

#include "SimplePrintf.h"

#include "NB.h"

#include "flash.h"

#include "SleepMode.h"

#include "communication_to_app.h"

#include "wakeup.h"

uint8_t yici=1;

u8 string_12_num=0;

u8 string_14_num=0;

u8 string_14_num_2=0;

u8 ReceivMAC_Flag;

u8 k=0;

u8 T=0;

char tempt1_Read_MAC[230];

char tempt2_Read_NAME[230];

char tempt3_Read_MAC[120];

char tempt4_Read_NAME[140];

char tempt5_Read_MAC[120];

char tempt6_Read_NAME[140];

char tempt7_Read_MAC[120];

char tempt8_Read_NAME[140];

char BlueNAME[255];//

char BlueMAC[216];//

char CurrentNAME_String[14];

char CurrentMAC_String[12];

char Connect_Fail_NAME_Buff[255];

char Connect_Fail_MAC_Buff[255];

char Fail_NAME[14];

char Fail_MAC[12];

uint8_t ReadBuff[30];

uint8_t StringConvert16_BlueNAME[216];

ConnectBlueTypedef ConnectBlueStruct;

Connect_Fail_typedef Connect_Fail_Struct;

//ASCII转字符

void AscillToString(char *InputData,char *OutputData,u8 length)

{

u8 i;

for(i=0;i<length;i++)

{

if(InputData[i]>='0'&&InputData[i]<='9')

{

OutputData[i] = InputData[i] -'0';

}

else if(InputData[i]>='A'&&InputData[i]<='F')

{

OutputData[i] = InputData[i] -'A';

OutputData[i] += 10;

}

else if(InputData[i]>='a'&&InputData[i]<='f')

{

OutputData[i] = InputData[i] - 'a';

OutputData[i] += 10;

}

}

}

//16进制数组转字符串

void HEXArrayToStringArray(uint8_t *inputdata,char *output,u16 length)

{

uint16_t i =0;

uint8_t TempBuff[254];

for(i=0;i<length;i++)

{

TempBuff[2*i] = inputdata[i]>>4;

TempBuff[2*i+1] = inputdata[i]&0x0f;

}

for(i=0;i<2*length;i++)

{

sprintf(&output[i],"%X",TempBuff[i]);

}

}

//16进制字符串转数组

void StringArrayToHEXArray(char *inputdata,char *output,u16 length)

{

int i,n = 0;

for(i = 0; i<(length-1); i += 2)//数组长度含结束符1Byte故减去一个长度

{

if(inputdata[i] >= 'A' && inputdata[i] <= 'F')

output[n] = inputdata[i] - 'A' + 10;

else if(inputdata[i] >= 'a' && inputdata[i] <= 'f')

output[n] = inputdata[i] - 'a' + 10;

else

output[n] = inputdata[i] - '0';

if(inputdata[i + 1] >= 'A' && inputdata[i + 1] <= 'F')

output[n] = (output[n] << 4) | (inputdata[i + 1] - 'A' + 10);

else if(inputdata[i + 1] >= 'a' && inputdata[i + 1] <= 'f')

output[n] = (output[n] << 4) | (inputdata[i + 1] - 'a' + 10);

else

output[n] = (output[n] << 4) | (inputdata[i + 1] - '0');

++n;

}

}

/***********************字符转16进制***********************************/

uint16_t StringToBytes( char* pSrc, uint8_t* pDst, uint16_t nSrcLength)

{

uint16_t i = 0;

for (i = 0; i < nSrcLength; i += 2)

{

if ((*pSrc >= '0') && (*pSrc <= '9'))

{

*pDst = (*pSrc - '0') << 4;

}

else if((*pSrc >= 'A') && (*pSrc <= 'F'))

{

*pDst = (*pSrc - 'A' + 10) << 4;

}

else

{

*pDst = (*pSrc - 'a' + 10) << 4;

}

pSrc++;

if ((*pSrc>='0') && (*pSrc<='9'))

{

*pDst |= (*pSrc - '0');

}

else if((*pSrc >= 'A') && (*pSrc <= 'F'))

{

*pDst |= (*pSrc - 'A' + 10);

}

else

{

*pDst |= (*pSrc - 'a' + 10);

}

pSrc++;

pDst++;

}

return (nSrcLength / 2);

}

//十进制转BCD,length为BCD长度

void DectoBCD(int Dec,char *Bcd, int length)

{

int i;

int temp;

for (i = length - 1; i >= 0; i--)

{

temp = Dec % 100;

Bcd[i] = ((temp / 10) << 4) + ((temp % 10) & 0x0F);

Dec /= 100;

}

}

// 查找字符串中，指定字符的位置

//F_data为字符数据

//num为第几个。返回结果为0则表示无此字符。

uint8_t find_data(char *dat , char F_data , uint8_t num )

{

char num_data=0;

uint8_t i=0;

for(i=0;i<255;i++)

{

if(dat[i] == F_data)

{

num_data++;

if(num_data == num)

return i+1;

}

}

return 0;

}

//查找字符串被查找字符位置，返回值ff为没有，其他值为存在地址

u8 FindStringToString(char *src, char *sub)

{

u8 ls,la,i;

ls = strlen(src);//被查找值

la = strlen(sub);//查找值

if (la > ls)

return 0xff;

for (i=0;i<=ls-la;i++)

{

if(strncmp(src+i,sub,la)==0)

return i;

}

return 0xff;

}

//查找指定位置字符串中是否包含有该字符串

char FindStringToStringPlace(char *src, char *sub,u8 StartBit)

{

u8 i,j,k;

char TempBuff[255];

i=strlen(src);

for(j=0;j<i-StartBit;j++)

{

TempBuff[j] = src[StartBit+j];

}

k= FindStringToString(TempBuff, sub)+StartBit;

return k;

}

//查找数组中指定起始位指定长度是否含有某个元素

//u8 FindSameData(char *input,char*output,u8 startbit,u8 length)

//{

// char temp[length];

// u8 i,j;

// for(i=0;i<length;i++)

// { temp[i] = input[startbit+i]; }

// j= (strstr(temp, output) != NULL);

// return j;

//}

//主模式下蓝牙扫描的数据核对

void Check_MAC(void)

{

if(USART2_RX_Buff[9]=='M'&&USART2_RX_Buff[10]=='A'&&USART2_RX_Buff[11]=='C')

{

if(USART2_RX_Buff[35]=='N'&&USART2_RX_Buff[36]=='A'&&USART2_RX_Buff[37]=='M'&&USART2_RX_Buff[38]=='E')

{

if(USART2_RX_Buff[26]=='R'&&USART2_RX_Buff[27]=='S')

{

if(USART2_RX_Buff[28]=='S'&&USART2_RX_Buff[29]=='I')

{

if(USART2_RX_Buff[40]=='J'&&USART2_RX_Buff[41]=='X')

{

ReceivMAC_Flag=1;

}

}

}

}

}

}

void BLUE_AT_M_Init(u8 Power)

{

char cmd[16],str[6];

itoi(str,Power);

strcpy(cmd, "AT+SCAN:RSSI=-");

strcat(cmd,str);

if(Blue_SendData_Flag ==1)

{

Blue_SendData_Flag=0;

switch (Blue_AT_num)

{

case 0: BLUE_POWER_OPEN();

BLUE_EN_ENABLE();

raw_printf("启动扫描:");

Blue_time =100;

break;

case 1:

USart_CLR_RecvBuf(2);

Uart2_SendAtCommand(cmd);

break;

default:

break;

}

}

}

void SaveMAC_NAME(uint8_t MAC_NUM,uint8_t NAME_NUM,uint8_t NUM,u8 Power)

{

u8 j=0;

u8 i=0;

char cmd[16],str[6];

itoi(str,Power);

strcpy(cmd, "AT+SCAN:RSSI=-");

strcat(cmd,str);

for(j=0;j<50;j++)

{

if(USART2_RX_Buff[j-2]=='J'&&USART2_RX_Buff[j-1]=='X')

{

for(i=0;i<14;i++){CurrentNAME_String[i]=USART2_RX_Buff[j++];}

}

}

if(strstr(BlueNAME,CurrentNAME_String) == NULL)

{

for(j=0;j<60;j++)

{

if(USART2_RX_Buff[j-2]=='J'&&USART2_RX_Buff[j-1]=='X')

{

for(i=0;i<14;i++){BlueNAME[i+NAME_NUM]=USART2_RX_Buff[j++];}

}

}

for(j=0;j<60;j++)

{

if(USART2_RX_Buff[j-4]=='M'&&USART2_RX_Buff[j-3]=='A'&&USART2_RX_Buff[j-2]=='C'&&USART2_RX_Buff[j-1]=='=')

{

for(i=0;i<12;i++){BlueMAC[i+MAC_NUM]=USART2_RX_Buff[j++];}

USart_CLR_RecvBuf(2);

Uart2_SendAtCommand(cmd);

}

}

}

else if(strstr(BlueNAME, CurrentNAME_String) != NULL)

{

LED2=!LED2;

USart_CLR_RecvBuf(2);

memset(CurrentNAME_String,0,sizeof(CurrentNAME_String));

Uart2_SendAtCommand(cmd);

k=NUM;

}

}

void Take_Out_NAME_MAC(u8 Power)

{

u8 j=0;

u8 i=0;

char cmd[16],str[6];

itoi(str,Power);

strcpy(cmd, "AT+SCAN:RSSI=-");

strcat(cmd,str);

// BlueDataRceiveModeStruct.Blue_AT_Mode=1;

// ConnectBlueStruct.ConnectBlueReceive_AT=1;

// BlueDataRceiveModeStruct.Blue_To_APP=0;

// BlueDataRceiveModeStruct.Blue_Data_Mode=0;

if(StringTimeTempt)

{

StringTimeTempt=0;

Check_MAC();

if(!ReceivMAC_Flag)

{

memset(BlueNAME,0,sizeof(BlueNAME));

memset(BlueMAC,0,sizeof(BlueMAC));

memset(CurrentNAME_String,0,sizeof(CurrentNAME_String));

USart_CLR_RecvBuf(2);

Uart2_SendAtCommand(cmd);

T=0;

k=0;

ReceivMAC_Flag=1;

}

if(ReceivMAC_Flag)

{

k++;

switch (k)

{

case 1: SaveMAC_NAME(0,0,0,80);

break;

case 2: SaveMAC_NAME(12,14,1,80);

break;

case 3: SaveMAC_NAME(24,28,2,80);

break;

case 4: SaveMAC_NAME(36,42,3,80);

break;

case 5: SaveMAC_NAME(48,56,4,80);

break;

case 6: SaveMAC_NAME(60,70,5,80);

break;

case 7: SaveMAC_NAME(72,84,6,80);

break;

case 8: SaveMAC_NAME(84,98,7,80);

break;

case 9: SaveMAC_NAME(96,112,8,80);

break;

case 10: SaveMAC_NAME(108,126,9,80);

break;

case 11: SaveMAC_NAME(120,140,10,80);

break;

case 12: SaveMAC_NAME(132,154,11,80);

break;

case 13: SaveMAC_NAME(144,168,12,80);

break;

case 14: SaveMAC_NAME(156,182,13,80);

break;

case 15: SaveMAC_NAME(168,196,14,80);

break;

case 16: SaveMAC_NAME(180,210,15,80);

break;

case 17: SaveMAC_NAME(192,224,16,80);

break;

case 18: for(j=0;j<12;j++){CurrentMAC_String[j]=USART2_RX_Buff[j+13];}

for(j=0;j<14;j++){CurrentNAME_String[j]=USART2_RX_Buff[j+42];}

if(strstr(BlueNAME, CurrentNAME_String) == NULL&&strstr(BlueMAC, CurrentMAC_String) == NULL)

{

for(j=0;j<60;j++)

{

if(USART2_RX_Buff[j-2]=='J'&&USART2_RX_Buff[j-1]=='X')

{

LED2=1;

for(i=0;i<14;i++){BlueNAME[i+238]=USART2_RX_Buff[j++];}

ConnectBlueStruct.ConnectBlueReceive_AT=0;

k=19;

//break;

}

if(USART2_RX_Buff[j-4]=='M'&&USART2_RX_Buff[j-3]=='A'&&USART2_RX_Buff[j-2]=='C'&&USART2_RX_Buff[j-1]=='=')

{

for(i=0;i<12;i++){BlueMAC[i+204]=USART2_RX_Buff[j++];}

}

}

delay_ms(300);

Uart3_SendLR();

raw_printf("扫描到的蓝牙表号:");

Uart3_SendLR();

USART3_Send_xbit(BlueNAME,252,14);//252

Uart3_SendLR();

raw_printf("扫描到的蓝牙MAC地址:");

Uart3_SendLR();

USART3_Send_xbit(BlueMAC,216,12);//216

Uart3_SendLR();

USart_CLR_RecvBuf(2);

// /*********扫描到的表号及MAC写入FLASH中*********/

STMFLASH_Write(SAVE_ADDR_NAME_1,(u16*)BlueNAME,140);

STMFLASH_Write(SAVE_ADDR_MAC_1,(u16*)BlueMAC,120);

for(i=0;i<112;i++){BlueNAME[i]=BlueNAME[i+140];}

for(i=0;i<96;i++){BlueMAC[i]=BlueNAME[i+120];}

STMFLASH_Write(SAVE_ADDR_NAME_2,(u16*)BlueNAME,112);

STMFLASH_Write(SAVE_ADDR_MAC_2,(u16*)BlueMAC,96);

// /******************/

CommunicationStruct.Start_Scan1=0;

ConnectBlueStruct.Connect_Number=0;

ConnectBlueStruct.StopScan=1;

}

else if(strstr(BlueNAME, CurrentNAME_String) != NULL)

{

USart_CLR_RecvBuf(2);

Uart2_SendAtCommand(cmd);

k=17;

}

break;

default:

break;

}

}

}

}

void Read_Data_Send(uint8_t a,uint8_t amc)//连接表端并读取表数据

{

u8 i;

char CONNECT[23];

if(BlueDataRceiveModeStruct.NB_UpdateBlueData_Success)

{

BlueDataRceiveModeStruct.Blue_AT_Mode=1;

BlueDataRceiveModeStruct.Blue_Data_Mode=0;

USart_CLR_RecvBuf(2);

Uart3_SendLR();

Uart2_SendAtCommand("AT+DISCONNECT");

memset(BlueDataRceiveModeStruct.DataMode.BlueDataBuff,0,sizeof(BlueDataRceiveModeStruct.DataMode.BlueDataBuff));

BlueDataRceiveModeStruct.NB_UpdateBlueData_Success=0;

ConnectBlueStruct.OK_flag=1;

}

else if(strstr(USART2_RX_Buff,"OK")!=NULL||strstr(USART2_RX_Buff,"ERROR")!=NULL)//||strstr(USART2_RX_Buff,"ERROR")!=NULL

{

memset(CONNECT,0,sizeof(CONNECT));

memset(Fail_NAME,0,sizeof(Fail_NAME));

strcpy(CONNECT,"AT+CONNECT=");

for(i=0;i<12;i++){CONNECT[i+11]=BlueMAC[i+amc];}

for(i=0;i<12;i++){Fail_MAC[i]=BlueMAC[i+amc];}

for(i=0;i<14;i++){Fail_NAME[i]=BlueNAME[i+string_14_num_2];}

string_14_num_2+=14;

USart_CLR_RecvBuf(2);

Uart3_SendLR();

Uart2_SendAtCommand(CONNECT);

ConnectBlueStruct.Connect_Time=3000;

ConnectBlueStruct.Connect_Number=a;

}

}

void Read_Data_Update(uint8_t a,uint8_t name)//上传表数据

{

u8 i;

char CONNECT[23];

if(strstr(USART2_RX_Buff, "AT+CONNECTED") != NULL)//连接成功

{

ConnectBlueStruct.Connect_Time=0;

ConnectBlueStruct.Connect_OverTime_Flag=0;

BlueDataRceiveModeStruct.Blue_AT_Mode=0;

BlueDataRceiveModeStruct.Blue_To_APP=0;

BlueDataRceiveModeStruct.Blue_Data_Mode=1;

memset(ReadBuff,0,sizeof(ReadBuff));

Read_Meter_19Protocol(name);

USART2_Send_Arr(ReadBuff,19);

USart_CLR_RecvBuf(2);

ConnectBlueStruct.ReadData_Time=10000;

}

else if(ConnectBlueStruct.Connect_OverTime_Flag )

{

ConnectBlueStruct.ReadData_Time=0;

ConnectBlueStruct.Connect_OverTime_Flag=0;

ConnectBlueStruct.ReadBlueData_fail=0;

if(strstr(USART2_RX_Buff, "AT+CONNECTED") == NULL)//连接失败

{

ConnectBlueStruct.Connect_fail_Num++;

raw_printf("连接表端失败,连接下一个");

memset(CONNECT,0,sizeof(CONNECT));

for(i=0;i<12;i++){Connect_Fail_MAC_Buff[i+string_12_num]=Fail_MAC[i];}

for(i=0;i<14;i++){Connect_Fail_NAME_Buff[i+string_14_num]=Fail_NAME[i];}

string_12_num+=12;

string_14_num+=14;

//BlueDataRceiveModeStruct.NB_UpdateBlueData_Success=1;

ConnectBlueStruct.Connect_Number=a;

Uart3_SendLR();

USart_CLR_RecvBuf(2);

Uart2_SendAtCommand("AT");

delay_ms(200);

Uart2_SendAtCommand("AT");

}

}

else if(ConnectBlueStruct.ReadBlueData_fail)

{

ConnectBlueStruct.ReadData_Time=0;

ConnectBlueStruct.ReadBlueData_fail=0;

ConnectBlueStruct.Connect_Time=0;

ConnectBlueStruct.Connect_fail_Num++;

raw_printf("读数据失败,连接下一个");

memset(CONNECT,0,sizeof(CONNECT));

BlueDataRceiveModeStruct.NB_UpdateBlueData_Success=1;

ConnectBlueStruct.Connect_Number=a;

USart_CLR_RecvBuf(2);

// Uart3_SendLR();

// Uart2_SendAtCommand("DISCONNECT");

}

else if(ConnectBlueStruct.ReadBlueData_Success)

{

ConnectBlueStruct.ReadBlueData_fail=0;

ConnectBlueStruct.ReadData_Time=0;

ConnectBlueStruct.ReadBlueData_Success=0;

USart_CLR_RecvBuf(1);

NB_Update_Data();

}

else if(strstr(USART1_RX_Buff,"OK")!=NULL)

{

BlueDataRceiveModeStruct.NB_UpdateBlueData_Success=1;

ConnectBlueStruct.Connect_Number=a;

//Uart2_SendAtCommand("DISCONNECT");

delay_ms(200);

USart_CLR_RecvBuf(1);

}

else if(strstr(USART1_RX_Buff,"ERROR")!=NULL)

{

USart_CLR_RecvBuf(1);

BlueDataRceiveModeStruct.NB_UpdateBlueData_Success=1;

ConnectBlueStruct.Connect_Number=a;

}

}

void Connect_Fail_Deal(void)

{

u8 i;

if(Connect_Fail_Struct.Fail_Num==1&&yici==1)

{

memset(BlueNAME,0,sizeof(BlueNAME));

memset(BlueMAC,0,sizeof(BlueMAC));

for(i=0;i<strlen(Connect_Fail_NAME_Buff);i++){BlueNAME[i]=Connect_Fail_NAME_Buff[i];}

for(i=0;i<strlen(Connect_Fail_MAC_Buff);i++){BlueMAC[i]=Connect_Fail_MAC_Buff[i];}

StringToBytes(BlueNAME,StringConvert16_BlueNAME,strlen(Connect_Fail_NAME_Buff));//蓝牙名称字符串转16进制

memset(Connect_Fail_NAME_Buff,0,sizeof(Connect_Fail_NAME_Buff));

memset(Connect_Fail_MAC_Buff,0,sizeof(Connect_Fail_MAC_Buff));

Connect_Fail_Struct.Fail_Lenth=(strlen(Connect_Fail_NAME_Buff))/14*2;

ConnectBlueStruct.Connect_quality=Connect_Fail_Struct.Fail_Lenth;

ConnectBlueStruct.connect_flag=1;

ConnectBlueStruct.BlueScanSuccess=1;

ConnectBlueStruct.Connect_Number=0;

ConnectBlueStruct.Connect_fail_Num=0;

string_14_num_2=0;

string_12_num=0;

string_14_num=0;

Connect_Fail_Struct.Fail_Num=0;

ConnectBlueStruct.Connect_fail_Num=0;

yici=2;

}

else if(yici==2)

{

if(ConnectBlueStruct.Connect_quality==ConnectBlueStruct.Connect_Number)

{

ConnectBlueStruct.connect_flag=0;

Work_Struct.Mode_type.JQZ_Mode.Update++;

ConnectBlueStruct.Connect_Number=0;

yici=0;

raw_printf("读取表端数据结束");

Uart2_SendAtCommand("AT+DISCONNECT");

delay_ms(100);

if(BLUE_CONNECT_COND==1)

{

Uart2_SendAtCommand("AT+DISCONNECT");

}

Uart2_SendAtCommand("AT");

}

}

}

void Connect_Blue_Read_Data(u8 jiedianshu)//读表数据

{

u8 i;

char CONNECT[23];

if(ConnectBlueStruct.Connect_quality==ConnectBlueStruct.Connect_Number&&yici==1)

{

ConnectBlueStruct.Connect_Number=100;

memset(Fail_NAME,0,sizeof(Fail_NAME));

// Uart3_SendLR();

// raw_printf("读取表数据失败的表号和MAC地址:");

// USART3_Send_xbit(Connect_Fail_NAME_Buff,strlen(Connect_Fail_NAME_Buff),14);

// Uart3_SendLR();

// USART3_Send_xbit(Connect_Fail_MAC_Buff,strlen(Connect_Fail_MAC_Buff),12);

Connect_Fail_Struct.Fail_Num=1;

Sleep_Mode_Struct.Enter_SleepMode_Time=10000;

}

switch(ConnectBlueStruct.Connect_Number)

{

case 0:

if(ConnectBlueStruct.BlueScanSuccess)//ConnectBlueStruct.BlueScanSuccess

{

memset(BlueDataRceiveModeStruct.DataMode.BlueDataStringBuff,0,sizeof(BlueDataRceiveModeStruct.DataMode.BlueDataStringBuff));

BlueDataRceiveModeStruct.Blue_AT_Mode=1;

BlueDataRceiveModeStruct.Blue_Data_Mode=0;

USart_CLR_RecvBuf(2);

Uart3_SendLR();

raw_printf("开始连接表端");

Uart2_SendAtCommand("AT+ROLE=M");//CLRBOND

ConnectBlueStruct.BlueScanSuccess=0;

}

else if(strstr(USART2_RX_Buff,"OK")!=NULL)

{

memset(CONNECT,0,sizeof(CONNECT));

memset(Fail_NAME,0,sizeof(Fail_NAME));

strcpy(CONNECT,"AT+CONNECT=");

for(i=0;i<12;i++){CONNECT[i+11]=BlueMAC[i];}

for(i=0;i<12;i++){Fail_MAC[i]=BlueMAC[i];}

for(i=0;i<14;i++){Fail_NAME[i]=BlueNAME[i+string_14_num_2];}

string_14_num_2+=14;

Uart3_SendLR();

USart_CLR_RecvBuf(2);

Uart2_SendAtCommand(CONNECT);

Uart3_SendLR();

memset(CONNECT,0,sizeof(CONNECT));

ConnectBlueStruct.Connect_Time=4000;

ConnectBlueStruct.Connect_Number=1;

memset(BlueDataRceiveModeStruct.DataMode.BlueDataBuff,0,sizeof(BlueDataRceiveModeStruct.DataMode.BlueDataBuff));

}

break;

case 1: Read_Data_Update(2,6);

break;

case 2: Read_Data_Send(3,12);

break;

case 3: Read_Data_Update(4,13);

break;

case 4: Read_Data_Send(5,24);

break;

case 5: Read_Data_Update(6,20);

break;

case 6: Read_Data_Send(7,36);

break;

case 7: Read_Data_Update(8,27);

break;

case 8: Read_Data_Send(9,48);

break;

case 9: Read_Data_Update(10,34);

break;

case 10: Read_Data_Send(11,60);

break;

case 11: Read_Data_Update(12,41);

break;

case 12: Read_Data_Send(13,72);

break;

case 13: Read_Data_Update(14,48);

break;

case 14: Read_Data_Send(15,84);

break;

case 15: Read_Data_Update(16,55);

break;

case 16: Read_Data_Send(17,96);

break;

case 17: Read_Data_Update(18,62);

break;

case 18: Read_Data_Send(19,108);

break;

// case 19: Read_Data_Update(20,69);

// break;

// case 20: Read_Data_Send(21,120);

// break;

//// case 21: Read_Data_Update(22,76);

// break;

// case 22: Read_Data_Send(23,132);

// break;

// case 23: Read_Data_Update(24,83);

// break;

// case 24: Read_Data_Send(25,144);

// break;

// case 25: Read_Data_Update(26,90);

// break;

// case 26: Read_Data_Send(27,156);

// break;

// case 27: Read_Data_Update(28,97);

// break;

// case 28: Read_Data_Send(29,168);

// break;

// case 29: Read_Data_Update(30,104);

// break;

// case 30: Read_Data_Send(31,180);

// break;

// case 31: Read_Data_Update(32,111);

// break;

// case 32: Read_Data_Send(33,192);

// break;

// case 33: Read_Data_Update(34,118);

// break;

// case 34: Read_Data_Send(35,204);

// break;

case 19: //Read_Data_Update(36,125);

if(strstr(USART2_RX_Buff, "AT+CONNECTED") != NULL)//连接成功

{

ConnectBlueStruct.Connect_Time=0;

BlueDataRceiveModeStruct.Blue_AT_Mode=0;

BlueDataRceiveModeStruct.Blue_Data_Mode=1;

//memset(ReadBuff,0,sizeof(ReadBuff));

Read_Meter_19Protocol(69);

USART2_Send_Arr(ReadBuff,19);

USart_CLR_RecvBuf(2);

ConnectBlueStruct.ReadData_Time=10000;

}

else if(ConnectBlueStruct.Connect_OverTime_Flag )

{

ConnectBlueStruct.Connect_OverTime_Flag=0;

if(strstr(USART2_RX_Buff, "AT+CONNECTED") == NULL)//连接失败

{

//Work_Struct.Mode_type.JQZ_Mode.Update++;

//ConnectBlueStruct.Connect_fail_Num++;

Uart3_SendLR();

raw_printf("连接蓝牙失败");

printf("%d",ConnectBlueStruct.Connect_fail_Num);

printf("个");

memset(Fail_NAME,0,sizeof(Fail_NAME));

for(i=0;i<12;i++){Connect_Fail_MAC_Buff[i+string_12_num]=Fail_MAC[i];}

string_14_num+=14;

for(i=0;i<14;i++){Connect_Fail_NAME_Buff[i+string_14_num]=Fail_NAME[i];}

raw_printf("读取表数据失败的表号和MAC地址:\r\n");

USART3_Send_xbit(Connect_Fail_NAME_Buff,strlen(Connect_Fail_NAME_Buff),14);

Uart3_SendLR();

USART3_Send_xbit(Connect_Fail_MAC_Buff,strlen(Connect_Fail_MAC_Buff),12);

memset(CONNECT,0,sizeof(CONNECT));

BlueDataRceiveModeStruct.NB_UpdateBlueData_Success=1;

ConnectBlueStruct.Connect_Number=20;

Connect_Fail_Struct.Fail_Num=1;

yici=1;

}

}

else if(ConnectBlueStruct.ReadBlueData_fail)

{

USART3_Send_xbit(Connect_Fail_MAC_Buff,strlen(Connect_Fail_MAC_Buff),12);

ConnectBlueStruct.ReadBlueData_fail=0;

ConnectBlueStruct.Connect_fail_Num++;

memset(CONNECT,0,sizeof(CONNECT));

BlueDataRceiveModeStruct.NB_UpdateBlueData_Success=1;

ConnectBlueStruct.Connect_Number=20;

USart_CLR_RecvBuf(2);

}

else if(ConnectBlueStruct.ReadBlueData_Success)

{

ConnectBlueStruct.ReadData_Time=0;

USart_CLR_RecvBuf(1);

NB_Update_Data();

ConnectBlueStruct.ReadBlueData_Success=0;

}

else if(strstr(USART1_RX_Buff,"OK")!=NULL)

{

Uart3_SendLR();

raw_printf("读取表数据失败的表号和MAC地址:\r\n");

USART3_Send_xbit(Connect_Fail_NAME_Buff,strlen(Connect_Fail_NAME_Buff),14);

USART3_Send_xbit(Connect_Fail_MAC_Buff,strlen(Connect_Fail_MAC_Buff),12);

Uart2_SendAtCommand("AT+DISCONNECT");

Connect_Fail_Struct.Fail_Num=1;

yici=1;

delay_ms(1000);

if(BLUE_CONNECT_COND==1)

{

Uart2_SendAtCommand("AT+DISCONNECT");

}

//Work_Struct.Mode_type.JQZ_Mode.Update++;

ConnectBlueStruct.Connect_Number=20;

}

break;

default: //ConnectBlueStruct.Connect_Number=100;

break;

}

}

extern char NAME[252];

extern char MAC[216];

void Read_NAME_AND_NAME(void)//从FLASH中读取表号和MAC地址

{

uint8_t i;

STMFLASH_Read(SAVE_ADDR_NAME_1,(u16*)tempt2_Read_NAME,70);

STMFLASH_Read(SAVE_ADDR_MAC_1,(u16*)tempt1_Read_MAC,60);

STMFLASH_Read(SAVE_ADDR_MAC_2,(u16*)tempt3_Read_MAC,60);

STMFLASH_Read(SAVE_ADDR_NAME_2,(u16*)tempt4_Read_NAME,70);

STMFLASH_Read(SAVE_ADDR_MAC_3,(u16*)tempt5_Read_MAC,60);

STMFLASH_Read(SAVE_ADDR_NAME_3,(u16*)tempt6_Read_NAME,70);

STMFLASH_Read(SAVE_ADDR_MAC_4,(u16*)tempt7_Read_MAC,60);

STMFLASH_Read(SAVE_ADDR_NAME_4,(u16*)tempt8_Read_NAME,70);

raw_printf("读到的表号和MAC地址:");

raw_printf("\r\n");

raw_printf("第1-10个：");

USART3_Send_xbit(tempt2_Read_NAME,140,14);//252

USART3_Send_xbit(tempt1_Read_MAC,120,12);//252

raw_printf("\r\n");

raw_printf("第11-20个：");

USART3_Send_xbit(tempt4_Read_NAME,140,14);//252

USART3_Send_xbit(tempt3_Read_MAC,120,12);//252

raw_printf("\r\n");

raw_printf("第21-30个：");

USART3_Send_xbit(tempt6_Read_NAME,140,14);//252

USART3_Send_xbit(tempt5_Read_MAC,120,12);//252

raw_printf("\r\n");

raw_printf("第31-40个：");

USART3_Send_xbit(tempt6_Read_NAME,140,14);//252

USART3_Send_xbit(tempt5_Read_MAC,120,12);//252

for(i=0;i<140;i++){BlueNAME[i]=tempt2_Read_NAME[i];}

for(i=0;i<120;i++){BlueMAC[i]=tempt1_Read_MAC[i];}

StringToBytes(BlueNAME,StringConvert16_BlueNAME,140);//蓝牙名称字符串转16进制

ConnectBlueStruct.Read_Flag=1;

}

//CS校验，输入数组名，数组长度，数据开始校验的地方

u8 CS_Check(uint8_t DataBuff[100],u8 length,u8 StartBit)//char DataBuff[100]

{

u8 i,j=0;

for(i=0;i<length;i++)

{

j+=DataBuff[i+StartBit];

}

__nop();

return j;

}

//读表数据协议格式

void Read_Meter_19Protocol(uint8_t QQ)

{

u8 i;

memset(ReadBuff,0,sizeof(ReadBuff));

ReadBuff[0] = 0xfe;

ReadBuff[1] = 0xfe;

ReadBuff[2] = 0xfe;

ReadBuff[3] = 0x68;//包头

ReadBuff[4] = 0x10;//表类型

for(i=0;i<7;i++)

{ReadBuff[5+i] = StringConvert16_BlueNAME[QQ-i];}

ReadBuff[12] = 0x01;//控制字

ReadBuff[13] = 0x03;//数据长度

ReadBuff[14] = 0x90;

ReadBuff[15] = 0x2f;

ReadBuff[16] = 0x00;//SER

ReadBuff[17] = CS_Check(ReadBuff,14,3);

ReadBuff[18] = 0x16;

}

## Communication_to_app.c

#include "communication_to_app.h"

#include "key.h"

#include "BlueTooth.h"

#include "BlueData_Deal.h"

#include "NB.h"

#include "delay.h"

#include "SimplePrintf.h"

#include "usart.h"

#include "flash.h"

#include "string.h"

#include "stdio.h"

#include "wakeup.h"

void KEY_Set_Blue_S_Mode(void)//按键设置蓝牙模式为从模式

{

if(KEY_Scan(1)==2)

{

Work_Struct.Mode_type.Weakup.WeakUP_Time=100;

Work_Struct.Mode_type.Sleep_Mode=0;

KEYStruct.KEY_Time++;

Work_Struct.Mode_type.Weakup.WeakUP_Time=0;

Work_Struct.Mode_type.Weakup.WeakUP_Over_Time =0;//&&NB_Struct.NB_Init==1

if(KEYStruct.KEY_Time==50)

{

weak_BLUE_init();

Sleep_Mode_Struct.WeakUP=0;

BlueDataRceiveModeStruct.Blue_AT_Mode=1;

ConnectBlueStruct.ConnectBlueReceive_AT=0;

BLUE_POWER_OPEN();

BLUE_EN_ENABLE();

CommunicationStruct.S_Mode_Start=1;

KEYStruct.KEY_Time=0;

}

}

if(CommunicationStruct.S_Mode_Start)

{

Work_Struct.Mode_type.Sleep_Mode=0;

Blue_S_AT_Config();

}

}

void Read_Device_information(void)//返回设备信息

{

u8 i;

uint8_t Tuff[30];

char information[18];

memset(Device_information_u8_Buff,0,sizeof(Device_information_u8_Buff));

STMFLASH_Read(FLASH_SAVE_ADDR+4096,(u16*)information,18);

StringToBytes(information,Device_information_u8_Buff,18);

Tuff[0]=0x68;

Tuff[1]=0x20;

for(i=0;i<7;i++){Tuff[2+i]=0xaa;}

Tuff[9]=0x32;

Tuff[10]=0x0d;

Tuff[11]=0x90;

Tuff[12]=0x2f;

Tuff[13]=0x00;

Tuff[14]=Device_information_u8_Buff[0];

Tuff[15]=Device_information_u8_Buff[1];

Tuff[16]=Device_information_u8_Buff[2];

Tuff[17]=Device_information_u8_Buff[3];

Tuff[18]=Device_information_u8_Buff[4];

Tuff[19]=Device_information_u8_Buff[5];

Tuff[20]=Device_information_u8_Buff[6];

Tuff[21]=Device_information_u8_Buff[7];

//for(j=0;j<8;j++){Tuff[14+j]=Device_information_u8_Buff[j];}

Tuff[22]=Device_information_u8_Buff[8];

Tuff[23]=0x00;//SER

Tuff[24] = CS_Check(Tuff,23,0);

Tuff[25]=0x16;

// USart_CLR_RecvBuf(3);

// USART3_Send_Arr(Tuff,25);

memset(CommunicationStruct.CommunicationBuff,0,sizeof(CommunicationStruct.CommunicationBuff));

USART2_Send_Arr(Tuff,26);

CommunicationStruct.Send_Device_information=0;

}

void Scan_Answer(void)//集中器扫描回复

{

u8 i;

uint8_t Tuff[30];

Tuff[0]=0x68;

Tuff[1]=0x20;

for(i=0;i<7;i++){Tuff[2+i]=0xaa;}

Tuff[9]=0x33;

Tuff[10]=0x05;

Tuff[11]=0x90;

Tuff[12]=0x3f;

Tuff[13]=0x00;

Tuff[14]=0xbb;

Tuff[15]=0x00;//SER

Tuff[16]=CS_Check(Tuff,16,0);

Tuff[17]=0x16;

// USart_CLR_RecvBuf(3);

// USART3_Send_Arr(Tuff,18);

memset(CommunicationStruct.CommunicationBuff,0,sizeof(CommunicationStruct.CommunicationBuff));

USART2_Send_Arr(Tuff,18);

}

void Read_name_mac(u8 ser)//集中器返回表号和MAC

{

u8 i;

uint8_t Tuff[200];

uint8_t BlueNAME_u8[72];

uint8_t BlueMAC_u8[62];

char name[142];

char mac[122];

memset(BlueNAME_u8,0,sizeof(BlueNAME_u8));

memset(BlueMAC_u8,0,sizeof(BlueMAC_u8));

memset(name,0,sizeof(name));

memset(mac,0,sizeof(mac));

switch(ser)

{

case 0x01:

{

STMFLASH_Read(SAVE_ADDR_NAME_1,(u16*)name,142);

STMFLASH_Read(SAVE_ADDR_MAC_1,(u16*)mac,122);

}

break;

case 0x02:

{

STMFLASH_Read(SAVE_ADDR_NAME_2,(u16*)name,142);

STMFLASH_Read(SAVE_ADDR_MAC_2,(u16*)mac,122);

}

break;

case 0x03:

{

STMFLASH_Read(SAVE_ADDR_NAME_3,(u16*)name,142);

STMFLASH_Read(SAVE_ADDR_MAC_3,(u16*)mac,122);

}

break;

case 0x04:

{

STMFLASH_Read(SAVE_ADDR_NAME_4,(u16*)name,142);

STMFLASH_Read(SAVE_ADDR_MAC_4,(u16*)mac,122);

}

case 0x05:

{

// for(i=0;i<142;i++){name[i]='0';}

// for(i=0;i<122;i++){mac[i]='0';}

memset(name,'0',sizeof(name));

memset(mac,'0',sizeof(mac));

}

break;

default:

break;

}

StringToBytes(name,BlueNAME_u8,142);

StringToBytes(mac,BlueMAC_u8,122);

Tuff[0]=0x68;

Tuff[1]=0x20;

for(i=0;i<7;i++){Tuff[2+i]=0xaa;}

Tuff[9]=0x35;

Tuff[10]=0x86;

Tuff[11]=0x90;

Tuff[12]=0x5f;

Tuff[13]=0x00;

for(i=0;i<70;i++){Tuff[14+i]=BlueNAME_u8[i];}

for(i=0;i<60;i++){Tuff[84+i]=BlueMAC_u8[i];}

Tuff[144]=ser;//SER

Tuff[145]=CS_Check(Tuff,144,0);

Tuff[146]=0x16;

memset(CommunicationStruct.CommunicationBuff,0,sizeof(CommunicationStruct.CommunicationBuff));

USART2_Send_Arr(Tuff,147);

}

void write_name_mac(u8 ser)//写表号后集中器返回

{

u8 i;

uint8_t Tuff[30];

Tuff[0]=0x68;

Tuff[1]=0x20;

for(i=0;i<7;i++){Tuff[2+i]=0xaa;}

Tuff[9]=0x34;

Tuff[10]=0x06;

Tuff[11]=0x90;

Tuff[12]=0x4f;

Tuff[13]=0x00;

Tuff[14]=0x80;

Tuff[15]=0x00;

Tuff[16]=ser;//SER

Tuff[17]=CS_Check(Tuff,16,0);

Tuff[18]=0x16;

// USart_CLR_RecvBuf(3);

// USART3_Send_Arr(Tuff,18);

memset(CommunicationStruct.CommunicationBuff,0,sizeof(CommunicationStruct.CommunicationBuff));

USART2_Send_Arr(Tuff,19);

}

void Set_JZQ_IP_Return(void)//设置集中器IP及端口返回

{

u8 i;

uint8_t Tuff[30];

Tuff[0]=0x68;

Tuff[1]=0x20;

for(i=0;i<7;i++){Tuff[2+i]=0xaa;}

Tuff[9]=0x95;

Tuff[10]=0x03;

Tuff[11]=0xB0;

Tuff[12]=0x19;

Tuff[13]=0x00;//SER

Tuff[14]=CS_Check(Tuff,14,0);

Tuff[15]=0x16;

// USart_CLR_RecvBuf(3);

// USART3_Send_Arr(Tuff,18);

memset(CommunicationStruct.CommunicationBuff,0,sizeof(CommunicationStruct.CommunicationBuff));

USART2_Send_Arr(Tuff,16);

}

void Read_JZQ_IP_COM(void)//读取集中器IP及端口返回

{

u8 i;

uint8_t Tuff[50];

STMFLASH_Read(FLASH_SAVE_ADDR+2048,(u16*)CommunicationStruct.IP_COM_u8,20);

HEXArrayToStringArray((u8*)CommunicationStruct.IP_COM_u8,CommunicationStruct.IP_COM_char,20);

Tuff[0]=0x68;

Tuff[1]=0x20;

for(i=0;i<7;i++){Tuff[2+i]=0xaa;}

Tuff[9]=0x83;

Tuff[10]=0x1a;

Tuff[11]=0x91;

Tuff[12]=0x0b;

Tuff[13]=0x00;

Tuff[14]=0x2c;

Tuff[15]=CommunicationStruct.IP_COM_u8[0];

Tuff[16]=CommunicationStruct.IP_COM_u8[1];

Tuff[17]=CommunicationStruct.IP_COM_u8[2];

Tuff[18]=CommunicationStruct.IP_COM_u8[3];

Tuff[19]=0x2c;

for(i=0;i<15;i++){Tuff[20+i]=CommunicationStruct.IP_COM_u8[i+5];}

Tuff[35]=0x00;

Tuff[36]=0x00;//SER

Tuff[37]=CS_Check(Tuff,35,0);

Tuff[38]=0x16;

memset(CommunicationStruct.CommunicationBuff,0,sizeof(CommunicationStruct.CommunicationBuff));

USART2_Send_Arr(Tuff,39);

}

void Clear_NAME_MAC(void)//清表节点返回

{

u8 i;

uint8_t Tuff[50];

Tuff[0]=0x68;

Tuff[1]=0x20;

for(i=0;i<7;i++){Tuff[2+i]=0xaa;}

Tuff[9]=0xa6;

Tuff[10]=0x05;

Tuff[11]=0xaa;

Tuff[12]=0xbb;

Tuff[13]=0x00;

Tuff[14]=0x00;

Tuff[15]=0x00;//SER

Tuff[16]=CS_Check(Tuff,16,0);

Tuff[17]=0x16;

memset(CommunicationStruct.CommunicationBuff,0,sizeof(CommunicationStruct.CommunicationBuff));

USART2_Send_Arr(Tuff,18);

//68 20 AA AA AA AA AA AA AA A6 05 AA BB 00 00 00 3E 16

}

void Error_Return(void)

{

u8 i;

uint8_t Tuff[50];

Tuff[0]=0x68;

Tuff[1]=0x20;

for(i=0;i<7;i++){Tuff[2+i]=0xaa;}

Tuff[9]=0x00;

Tuff[10]=0x05;

Tuff[11]=0xff;

Tuff[12]=0xff;

Tuff[13]=0xff;

Tuff[14]=0xff;

Tuff[15]=0xff;//SER

Tuff[16]=CS_Check(Tuff,16,0);

Tuff[17]=0x16;

memset(CommunicationStruct.CommunicationBuff,0,sizeof(CommunicationStruct.CommunicationBuff));

USART2_Send_Arr(Tuff,18);

}

void Determine_Deveice(void)

{

if(CommunicationStruct.Receive_Over_Time)

{

if(CommunicationStruct.CommunicationBuff[CommunicationStruct.CommunicationBuff[10]+12]!=0x16)

{

OLED_Clear();

OLED_Display_GB2312_string(1,6,"接收数据错误！！");

Error_Return();

CommunicationStruct.Communication_RX_Cont=0;

memset(CommunicationStruct.CommunicationBuff,0,sizeof(CommunicationStruct.CommunicationBuff));

CommunicationStruct.Receive_Time=0;

CommunicationStruct.Receive_Over_Time=0;

}

}

}

void APP_To_BlueScan(uint32_t time)//APP启动扫描

{

u8 i;

if(CommunicationStruct.Start)

{

BlueDataRceiveModeStruct.Blue_AT_Mode=2;

ConnectBlueStruct.ConnectBlueReceive_AT=1;

BlueDataRceiveModeStruct.Blue_To_APP=0;

BlueDataRceiveModeStruct.Blue_Data_Mode=0;

ConnectBlueStruct.connect_flag=0;

CommunicationStruct.Start_Scan1=1;

BLUE_POWER_CLOSE();

BLUE_EN_DISABLE();

delay_ms(500);

BLUE_POWER_OPEN();

BLUE_EN_ENABLE();

ConnectBlueStruct.ScanTime=time;

Uart2_SendAtCommand("AT+ROLE=M");

delay_ms(200);

Uart2_SendAtCommand("AT+SCAN:RSSI=-80");

CommunicationStruct.Start=0;

}

if(CommunicationStruct.Start_Scan1)

{

Take_Out_NAME_MAC(80);

}

if(ConnectBlueStruct.Scan_OverTime_Flag)

{

Uart2_SendAtCommand("AT+STOPSCAN");

delay_ms(100);

Uart3_SendLR();

printf("扫描结束,扫描到的表端数量：");

printf("%d",strlen(BlueNAME)/14);

CommunicationStruct.Start_Scan1=0;

for(i=0;i<(252-strlen(BlueNAME));i++){BlueNAME[strlen(BlueNAME)+i]='0';}

for(i=0;i<(216-strlen(BlueMAC));i++){BlueMAC[strlen(BlueMAC)+i]='0';}

STMFLASH_Write(SAVE_ADDR_NAME_1,(u16*)BlueNAME,140);

STMFLASH_Write(SAVE_ADDR_MAC_1,(u16*)BlueMAC,120);

for(i=0;i<112;i++){BlueNAME[i]=BlueNAME[i+140];}

for(i=0;i<96;i++){BlueMAC[i]=BlueMAC[i+120];}

STMFLASH_Write(SAVE_ADDR_NAME_2,(u16*)BlueNAME,112);

STMFLASH_Write(SAVE_ADDR_MAC_2,(u16*)BlueMAC,96);

Blue_Flag_Init();

ConnectBlueStruct.Scan_OverTime_Flag=0;

}

}

void write_mac_name(uint8_t ser,uint32_t name_addr,uint32_t mac_addr)

{

u8 i;

uint8_t tempt_name[142];

uint8_t tempt_mac[122];

char name_222[142];

char mac_222[122];

memset(name_222,0,sizeof(name_222));

memset(mac_222,0,sizeof(mac_222));

memset(tempt_name,0,sizeof(tempt_name));

memset(tempt_mac,0,sizeof(tempt_mac));

for(i=0;i<70;i++){tempt_name[i]=CommunicationStruct.CommunicationBuff[14+i];}

for(i=0;i<60;i++){tempt_mac[i]=CommunicationStruct.CommunicationBuff[84+i];}

HEXArrayToStringArray(tempt_name,name_222,71);

HEXArrayToStringArray(tempt_mac,mac_222,61);

STMFLASH_Write(name_addr,(u16*)name_222,142);

STMFLASH_Write(mac_addr,(u16*)mac_222,122);

CommunicationStruct.Communication_RX_Cont=0;

memset(CommunicationStruct.CommunicationBuff,0,sizeof(CommunicationStruct.CommunicationBuff));

write_name_mac(ser);//写表号返回

CommunicationStruct.write_ser=0x00;

}

void JZQ_Write_NAME_MAC(void)

{

switch(CommunicationStruct.write_ser)

{

case 0x01:write_mac_name(0x01,SAVE_ADDR_NAME_1,SAVE_ADDR_MAC_1);

break;

case 0x02:write_mac_name(0x02,SAVE_ADDR_NAME_2,SAVE_ADDR_MAC_2);

break;

case 0x03:write_mac_name(0x03,SAVE_ADDR_NAME_3,SAVE_ADDR_MAC_3);

break;

case 0x04:write_mac_name(0x04,SAVE_ADDR_NAME_4,SAVE_ADDR_MAC_4);

break;

default:

break;

}

}

void APP_TO_JZQ_CB_RETURN(void)

{

u8 i;

uint8_t Tuff[50];

Tuff[0]=0x68;

Tuff[1]=0x20;

for(i=0;i<7;i++){Tuff[2+i]=0xaa;}

Tuff[9]=0x36;

Tuff[10]=0x04;

Tuff[11]=0xc1;

Tuff[12]=0xb1;

Tuff[13]=0x11;

Tuff[14]=0x00;

Tuff[15]=CS_Check(Tuff,15,0);

Tuff[16]=0x16;

memset(CommunicationStruct.CommunicationBuff,0,sizeof(CommunicationStruct.CommunicationBuff));

USART2_Send_Arr(Tuff,17);

}

## Oled.c

#include "oled.h"

#include "stdlib.h"

#include "delay.h"

#include "beep.h"

//反显函数

OLEDTypedef OLEDStruct;

void OLED_ColorTurn(u8 i)

{

if(i==0)

{

OLED_WR_Byte(0xA6,OLED_CMD);//正常显示

}

if(i==1)

{

OLED_WR_Byte(0xA7,OLED_CMD);//反色显示

}

}

//屏幕旋转180度

void OLED_DisplayTurn(u8 i)

{

if(i==0)

{

OLED_WR_Byte(0xC8,OLED_CMD);//正常显示

OLED_WR_Byte(0xA1,OLED_CMD);

}

if(i==1)

{

OLED_WR_Byte(0xC0,OLED_CMD);//反转显示

OLED_WR_Byte(0xA0,OLED_CMD);

}

}

//向SSD1306写入一个字节。

//mode:数据/命令标志 0,表示命令;1,表示数据;

void OLED_WR_Byte(u32 dat,u8 mode)

{

u8 i;

if(mode)

{

OLED_DC_Set(); //写数据

}

else

{

OLED_DC_Clr(); //写命令

}

OLED_CS_Clr();

for(i=0;i<8;i++)

{

OLED_SCLK_Clr();//将时钟信号设置为低电平

if(dat&0x80)//将dat的8位从最高位依次写入

{

OLED_SDIN_Set();

}

else

{

OLED_SDIN_Clr();

}

OLED_SCLK_Set();//将时钟信号设置为高电平

dat<<=1;

}

OLED_CS_Set();

OLED_DC_Set();

}

//清屏函数

void OLED_Clear(void)

{

u8 i,n;

for(i=0;i<8;i++)

{

OLED_WR_Byte(0xb0+i,OLED_CMD);

OLED_WR_Byte(0x10,OLED_CMD);

OLED_WR_Byte(0x02,OLED_CMD);

for(n=0;n<128;n++)

{

OLED_WR_Byte(0x00,OLED_DATA);//清除所有数据

}

}

}

//设置起始地址

void OLED_address(u8 x,u8 y)

{

OLED_WR_Byte(0xb0+y,OLED_CMD); //设置页地址

OLED_WR_Byte((((x+2)&0xf0)>>4)|0x10,OLED_CMD); //设置列地址的高4位

OLED_WR_Byte(((x+2)&0x0f),OLED_CMD); //设置列地址的低4位

}

//显示128x64点阵图像

void OLED_Display_128x64(u8 *dp)

{

u8 i,j;

for(i=0;i<8;i++)

{

OLED_address(0,i);

for(j=0;j<128;j++)

{

OLED_WR_Byte(*dp,OLED_DATA); //写数据到OLED,每写完一个8位的数据后列地址自动加1

dp++;

}

}

}

//显示16x16点阵图像、汉字、生僻字或16x16点阵的其他图标

void OLED_Display_16x16(u32 x,u32 y,u8 *dp)

{

u8 i,j;

for(j=0;j<2;j++)

{

OLED_address(x,y);

for(i=0;i<16;i++)

{

OLED_WR_Byte(*dp,OLED_DATA); //写数据到LCD,每写完一个8位的数据后列地址自动加1

dp++;

}

y++;

}

}

//显示8x16点阵图像、ASCII, 或8x16点阵的自造字符、其他图标

void OLED_Display_8x16(u8 x,u32 y,u8 *dp)

{

u8 i,j;

for(j=0;j<2;j++)

{

OLED_address(x,y);

for(i=0;i<8;i++)

{

OLED_WR_Byte(*dp,OLED_DATA); //写数据到LCD,每写完一个8位的数据后列地址自动加1

dp++;

}

y++;

}

}

//显示5*7点阵图像、ASCII, 或5x7点阵的自造字符、其他图标

void OLED_Display_5x7(u8 x,u32 y,u8 *dp)

{

u8 i;

OLED_address(x,y);

for(i=0;i<6;i++)

{

OLED_WR_Byte(*dp,OLED_DATA);

dp++;

}

}

//送指令到晶联讯字库IC

void Send_Command_to_ROM(u8 dat)

{

u8 i;

for(i=0;i<8;i++)

{

OLED_SCLK_Clr();

if(dat&0x80)

{

OLED_SDIN_Set();

}

else

{

OLED_SDIN_Clr();

}

dat<<=1;

OLED_SCLK_Set();

}

}

//从晶联讯字库IC中取汉字或字符数据（1个字节）

u8 Get_data_from_ROM()

{

u8 i,read=0;

for(i=0;i<8;i++)

{

OLED_SCLK_Clr();

read<<=1;

if(GPIO_ReadInputDataBit(GPIOB,GPIO_Pin_5))

{

read=read+1;

}

else

{

read=read;

}

OLED_SCLK_Set();

}

return read;

}

//从相关地址（addrHigh：地址高字节,addrMid：地址中字节,addrLow：地址低字节）中连续读出DataLen个字节的数据到 pbuff的地址

//连续读取

void OLED_get_data_from_ROM(u8 addrHigh,u8 addrMid,u8 addrLow,u8 *pbuff,u8 DataLen)

{

u8 i;

OLED_ROM_CS_Clr();

OLED_CS_Set();

Send_Command_to_ROM(0x03);

Send_Command_to_ROM(addrHigh);

Send_Command_to_ROM(addrMid);

Send_Command_to_ROM(addrLow);

for(i=0;i<DataLen;i++)

{

*(pbuff+i)=Get_data_from_ROM();

}

OLED_ROM_CS_Set();

}

u8long fontaddr=0;

void OLED_Display_GB2312_string(u8 x,u8 y,u8 *text)

{

u8 i=0;

u8 addrHigh,addrMid,addrLow;

u8 fontbuf[32];

while(text[i]>0x00)

{

if((text[i]>=0xb0)&&(text[i]<=0xf7)&&(text[i+1]>=0xa1))

{

//国标简体（GB2312）汉字在晶联讯字库IC中的地址由以下公式来计算：

//Address = ((MSB - 0xB0) * 94 + (LSB - 0xA1)+ 846)*32+ BaseAdd;BaseAdd=0

//由于担心8位单片机有乘法溢出问题，所以分三部取地址

fontaddr=(text[i]-0xb0)*94;

fontaddr+=(text[i+1]-0xa1)+846;

fontaddr=(u8long)(fontaddr*32);

addrHigh=(fontaddr&0xff0000)>>16; //地址的高8位,共24位

addrMid=(fontaddr&0xff00)>>8; //地址的中8位,共24位

addrLow=(fontaddr&0xff); //地址的低8位,共24位

OLED_get_data_from_ROM(addrHigh,addrMid,addrLow,fontbuf,32);

//取32个字节的数据，存到"fontbuf[32]"

OLED_Display_16x16(x,y,fontbuf);

//显示汉字到LCD上，y为页地址，x为列地址，fontbuf[]为数据

x+=16;

i+=2;

}

else if((text[i]>=0xa1)&&(text[i]<=0xa3)&&(text[i+1]>=0xa1))

{

fontaddr=(text[i]-0xa1)*94;

fontaddr+=(text[i+1]-0xa1);

fontaddr=(u8long)(fontaddr*32);

addrHigh=(fontaddr&0xff0000)>>16;

addrMid=(fontaddr&0xff00)>>8;

addrLow=(fontaddr&0xff);

OLED_get_data_from_ROM(addrHigh,addrMid,addrLow,fontbuf,32);

OLED_Display_16x16(x,y,fontbuf);

x+=16;

i+=2;

}

else if((text[i]>=0x20)&&(text[i]<=0x7e))

{

unsigned char fontbuf[16];

fontaddr=(text[i]-0x20);

fontaddr=(unsigned long)(fontaddr*16);

fontaddr=(unsigned long)(fontaddr+0x3cf80);

addrHigh=(fontaddr&0xff0000)>>16;

addrMid=(fontaddr&0xff00)>>8;

addrLow=fontaddr&0xff;

OLED_get_data_from_ROM(addrHigh,addrMid,addrLow,fontbuf,16);

OLED_Display_8x16(x,y,fontbuf);

x+=8;

i+=1;

}

else

i++;

}

}

void OLED_Display_string_5x7(u8 x,u8 y,u8 *text)

{

u8 i=0;

u8 addrHigh,addrMid,addrLow;

while(text[i]>0x00)

{

if((text[i]>=0x20)&&(text[i]<=0x7e))

{

u8 fontbuf[8];

fontaddr=(text[i]-0x20);

fontaddr=(unsigned long)(fontaddr*8);

fontaddr=(unsigned long)(fontaddr+0x3bfc0);

addrHigh=(fontaddr&0xff0000)>>16;

addrMid=(fontaddr&0xff00)>>8;

addrLow=fontaddr&0xff;

OLED_get_data_from_ROM(addrHigh,addrMid,addrLow,fontbuf,8);

OLED_Display_5x7(x,y,fontbuf);

x+=6;

i+=1;

}

else

i++;

}

}

//显示2个数字

//x,y :起点坐标

//num1：要显示的小数

//len :数字的位数

void OLED_ShowNum(u8 x,u8 y,float num1,u8 len)

{

u8 i;

u32 t,num;

x=x+len*8+8;//要显示的小数最低位的横坐标

num=num1*100;//将小数左移两位并转化为整数

OLED_Display_GB2312_string(x-24,y,".");//显示小数点

for(i=0;i<len;i++)

{

t=num%10;//取个位数的数值

num=num/10;//将整数右移一位

x-=8;

if(i==2){x-=8;}//当显示出来两个小数之后，空出小数点的位置

switch(t)

{

case 0 :OLED_Display_GB2312_string(x,y,"0");break;

case 1 :OLED_Display_GB2312_string(x,y,"1");break;

case 2 :OLED_Display_GB2312_string(x,y,"2");break;

case 3 :OLED_Display_GB2312_string(x,y,"3");break;

case 4 :OLED_Display_GB2312_string(x,y,"4");break;

case 5 :OLED_Display_GB2312_string(x,y,"5");break;

case 6 :OLED_Display_GB2312_string(x,y,"6");break;

case 7 :OLED_Display_GB2312_string(x,y,"7");break;

case 8 :OLED_Display_GB2312_string(x,y,"8");break;

case 9 :OLED_Display_GB2312_string(x,y,"9");break;

}

}

}

//OLED的初始化

void OLED_Init(void)

{

GPIO_InitTypeDef GPIO_InitStructure;

RCC_APB2PeriphClockCmd(RCC_APB2Periph_GPIOB|RCC_APB2Periph_AFIO, ENABLE); //使能A端口时钟

GPIO_PinRemapConfig(GPIO_Remap_SWJ_JTAGDisable, ENABLE);

GPIO_InitStructure.GPIO_Pin = GPIO_Pin_9|GPIO_Pin_8|GPIO_Pin_7|GPIO_Pin_6|GPIO_Pin_5|GPIO_Pin_4;

GPIO_InitStructure.GPIO_Mode = GPIO_Mode_Out_PP; //推挽输出

GPIO_InitStructure.GPIO_Speed = GPIO_Speed_50MHz;//速度50MHz

GPIO_Init(GPIOB, &GPIO_InitStructure); //初始化GPIOD3,6

GPIO_SetBits(GPIOB,GPIO_Pin_9|GPIO_Pin_8|GPIO_Pin_7|GPIO_Pin_6|GPIO_Pin_5|GPIO_Pin_4);

RCC_APB2PeriphClockCmd(RCC_APB2Periph_GPIOB|RCC_APB2Periph_AFIO, ENABLE);

GPIO_InitStructure.GPIO_Pin = GPIO_Pin_5;

GPIO_InitStructure.GPIO_Mode = GPIO_Mode_IPD; //推挽输出

GPIO_Init(GPIOB, &GPIO_InitStructure); //初始化GPIOA4

OLED_WR_Byte(0xAE,OLED_CMD);//--turn off oled panel

OLED_WR_Byte(0x00,OLED_CMD);//---set low column address

OLED_WR_Byte(0x10,OLED_CMD);//---set high column address

OLED_WR_Byte(0x40,OLED_CMD);//--set start line address Set Mapping RAM Display Start Line (0x00~0x3F)

OLED_WR_Byte(0x81,OLED_CMD);//--set contrast control register

OLED_WR_Byte(0xCF,OLED_CMD);// Set SEG Output Current Brightness

OLED_WR_Byte(0xA1,OLED_CMD);//--Set SEG/Column Mapping 0xa0左右反置 0xa1正常

OLED_WR_Byte(0xC8,OLED_CMD);//Set COM/Row Scan Direction 0xc0上下反置 0xc8正常

OLED_WR_Byte(0xA6,OLED_CMD);//--set normal display

OLED_WR_Byte(0xA8,OLED_CMD);//--set multiplex ratio(1 to 64)

OLED_WR_Byte(0x3f,OLED_CMD);//--1/64 duty

OLED_WR_Byte(0xD3,OLED_CMD);//-set display offset Shift Mapping RAM Counter (0x00~0x3F)

OLED_WR_Byte(0x00,OLED_CMD);//-not offset

OLED_WR_Byte(0xd5,OLED_CMD);//--set display clock divide ratio/oscillator frequency

OLED_WR_Byte(0x80,OLED_CMD);//--set divide ratio, Set Clock as 100 Frames/Sec

OLED_WR_Byte(0xD9,OLED_CMD);//--set pre-charge period

OLED_WR_Byte(0xF1,OLED_CMD);//Set Pre-Charge as 15 Clocks & Discharge as 1 Clock

OLED_WR_Byte(0xDA,OLED_CMD);//--set com pins hardware configuration

OLED_WR_Byte(0x12,OLED_CMD);

OLED_WR_Byte(0xDB,OLED_CMD);//--set vcomh

OLED_WR_Byte(0x40,OLED_CMD);//Set VCOM Deselect Level

OLED_WR_Byte(0x20,OLED_CMD);//-Set Page Addressing Mode (0x00/0x01/0x02)

OLED_WR_Byte(0x02,OLED_CMD);//

OLED_WR_Byte(0x8D,OLED_CMD);//--set Charge Pump enable/disable

OLED_WR_Byte(0x14,OLED_CMD);//--set(0x10) disable

OLED_WR_Byte(0xA4,OLED_CMD);// Disable Entire Display On (0xa4/0xa5)

OLED_WR_Byte(0xA6,OLED_CMD);// Disable Inverse Display On (0xa6/a7)

OLED_WR_Byte(0xAF,OLED_CMD);

}

## Beep.c

#include "beep.h"

void BEEP_GPIO_Init(void)

{

GPIO_InitTypeDef GPIO_InitStructure;

RCC_APB2PeriphClockCmd(RCC_APB2Periph_GPIOB,ENABLE);

GPIO_InitStructure.GPIO_Mode =GPIO_Mode_Out_PP;

GPIO_InitStructure.GPIO_Pin =GPIO_Pin_3;

GPIO_InitStructure.GPIO_Speed = GPIO_Speed_2MHz;

GPIO_Init(GPIOB,&GPIO_InitStructure);

GPIO_ResetBits(GPIOB,GPIO_Pin_3);

}

void BEEP_ON(uint8_t times)

{

u8 i;

if(times>0)

{

for(i=0;i<times;i++)

{

BEEP=1;

delay_ms(40);

BEEP=0;

delay_ms(40);

}

}

else

{

BEEP=0;

}

}

## Flash.c

#include "flash.h"

FLASH_TYPEDEF FLASH_Struct;

//读取指定地址的半字(16位数据)

//faddr:读地址(此地址必须为2的倍数!!)

//返回值:对应数据.

u16 STMFLASH_ReadHalfWord(u32 faddr)

{

return *(vu16*)faddr;

}

#if STM32_FLASH_WREN //如果使能了写

//不检查的写入

//WriteAddr:起始地址

//pBuffer:数据指针

//NumToWrite:半字(16位)数

void STMFLASH_Write_NoCheck(u32 WriteAddr,u16 *pBuffer,u16 NumToWrite)

{

u16 i;

for(i=0;i<NumToWrite;i++)

{

FLASH_ProgramHalfWord(WriteAddr,pBuffer[i]);

WriteAddr+=2;//地址增加2.

}

}

//从指定地址开始写入指定长度的数据

//WriteAddr:起始地址(此地址必须为2的倍数!!)

//pBuffer:数据指针

//NumToWrite:半字(16位)数(就是要写入的16位数据的个数.)

#if STM32_FLASH_SIZE<256

#define STM_SECTOR_SIZE 1024 //字节

#else

#define STM_SECTOR_SIZE 2048

#endif

u16 STMFLASH_BUF[STM_SECTOR_SIZE/2];//最多是2K字节

void STMFLASH_Write(u32 WriteAddr,u16 *pBuffer,u16 NumToWrite)

{

u32 secpos; //扇区地址

u16 secoff; //扇区内偏移地址(16位字计算)

u16 secremain; //扇区内剩余地址(16位字计算)

u16 i;

u32 offaddr; //去掉0X08000000后的地址

if(WriteAddr<STM32_FLASH_BASE||(WriteAddr>=(STM32_FLASH_BASE+1024*STM32_FLASH_SIZE)))return;//非法地址

FLASH_Unlock(); //解锁

offaddr=WriteAddr-STM32_FLASH_BASE; //实际偏移地址.

secpos=offaddr/STM_SECTOR_SIZE; //扇区地址 0~127 for STM32F103RBT6

secoff=(offaddr%STM_SECTOR_SIZE)/2; //在扇区内的偏移(2个字节为基本单位.)

secremain=STM_SECTOR_SIZE/2-secoff; //扇区剩余空间大小

if(NumToWrite<=secremain)secremain=NumToWrite;//不大于该扇区范围

while(1)

{

STMFLASH_Read(secpos*STM_SECTOR_SIZE+STM32_FLASH_BASE,STMFLASH_BUF,STM_SECTOR_SIZE/2);//读出整个扇区的内容

for(i=0;i<secremain;i++)//校验数据

{

if(STMFLASH_BUF[secoff+i]!=0XFFFF)break;//需要擦除

}

if(i<secremain)//需要擦除

{

FLASH_ErasePage(secpos*STM_SECTOR_SIZE+STM32_FLASH_BASE);//擦除这个扇区

for(i=0;i<secremain;i++)//复制

{

STMFLASH_BUF[i+secoff]=pBuffer[i];

}

STMFLASH_Write_NoCheck(secpos*STM_SECTOR_SIZE+STM32_FLASH_BASE,STMFLASH_BUF,STM_SECTOR_SIZE/2);//写入整个扇区

}else STMFLASH_Write_NoCheck(WriteAddr,pBuffer,secremain);//写已经擦除了的,直接写入扇区剩余区间.

if(NumToWrite==secremain)break;//写入结束了

else//写入未结束

{

secpos++; //扇区地址增1

secoff=0; //偏移位置为0

pBuffer+=secremain; //指针偏移

WriteAddr+=secremain; //写地址偏移

NumToWrite-=secremain; //字节(16位)数递减

if(NumToWrite>(STM_SECTOR_SIZE/2))secremain=STM_SECTOR_SIZE/2;//下一个扇区还是写不完

else secremain=NumToWrite;//下一个扇区可以写完了

}

};

FLASH_Lock();//上锁

}

#endif

//从指定地址开始读出指定长度的数据

//ReadAddr:起始地址

//pBuffer:数据指针

//NumToWrite:半字(16位)数

void STMFLASH_Read(u32 ReadAddr,u16 *pBuffer,u16 NumToRead)

{

u16 i;

for(i=0;i<NumToRead;i++)

{

pBuffer[i]=STMFLASH_ReadHalfWord(ReadAddr);//读取2个字节.

ReadAddr+=2;//偏移2个字节.

}

}

//WriteAddr:起始地址

//WriteData:要写入的数据

void Test_Write(u32 WriteAddr,u16 WriteData)

{

STMFLASH_Write(WriteAddr,&WriteData,1);//写入一个字

}

# 第2章 系统原理图

系统原理图设计如图 2-1所示

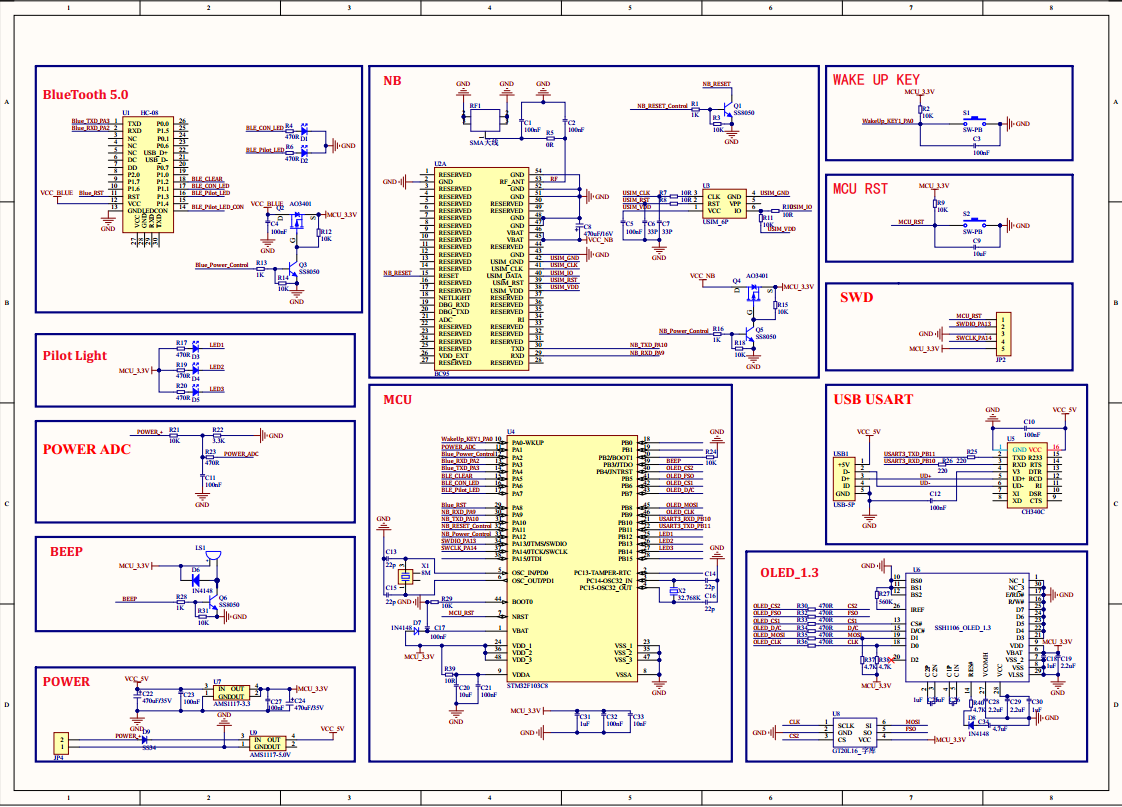
[picture p1: figure]

图 2-1 图系统原理图

# 第3章 系统PCB板

系统PCB板设计图 3-1如所示

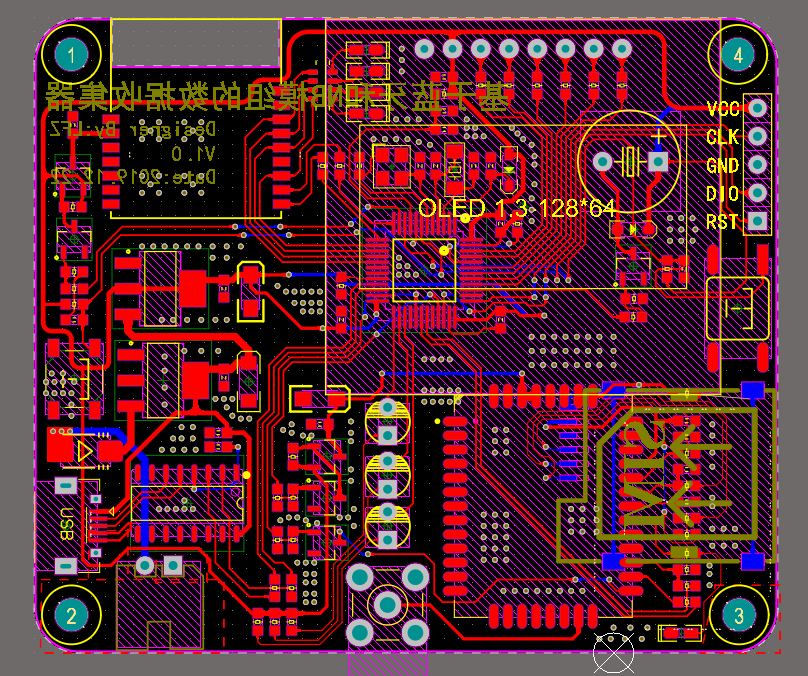
[picture p2: figure]

图 3-1 系统PCB板图

# 第4章 PCB 3D图

系统PCB板设计3D如图 4-1所示

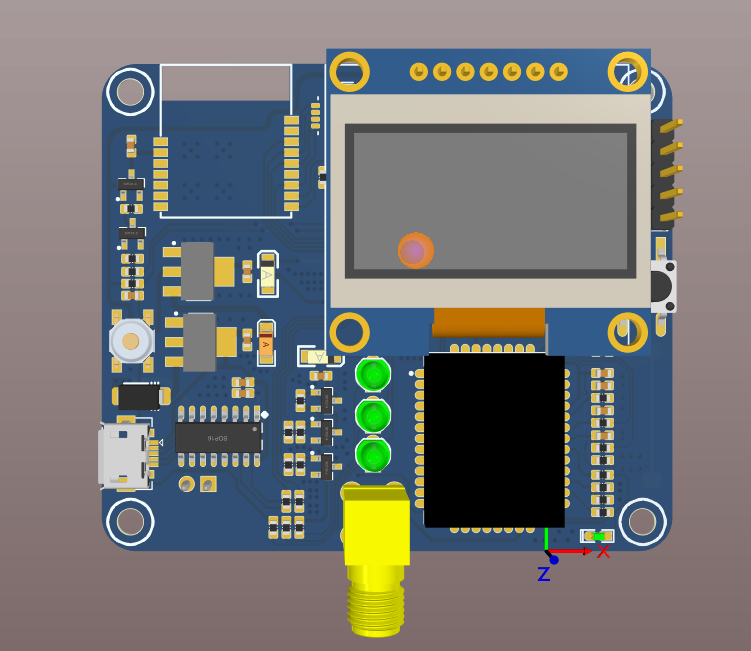
[picture p3: figure]

图 4-1数据采集器PCB 3D图

# 第5章 实物图

收据采集器实物如图 5-1所示

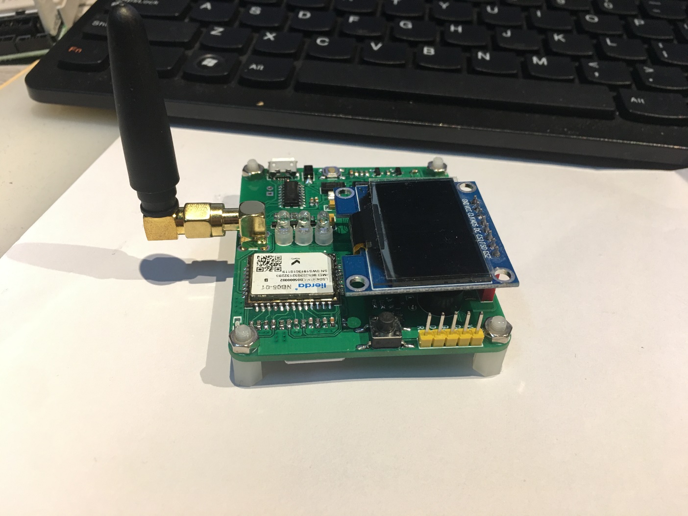
[picture p4: figure]

图 5-1数据采集器实物图
