luofanzhi/NB_DATA_COLLECT/PCB及BOM表/数据收集器_V2.0/数据收集器_Project.pdf

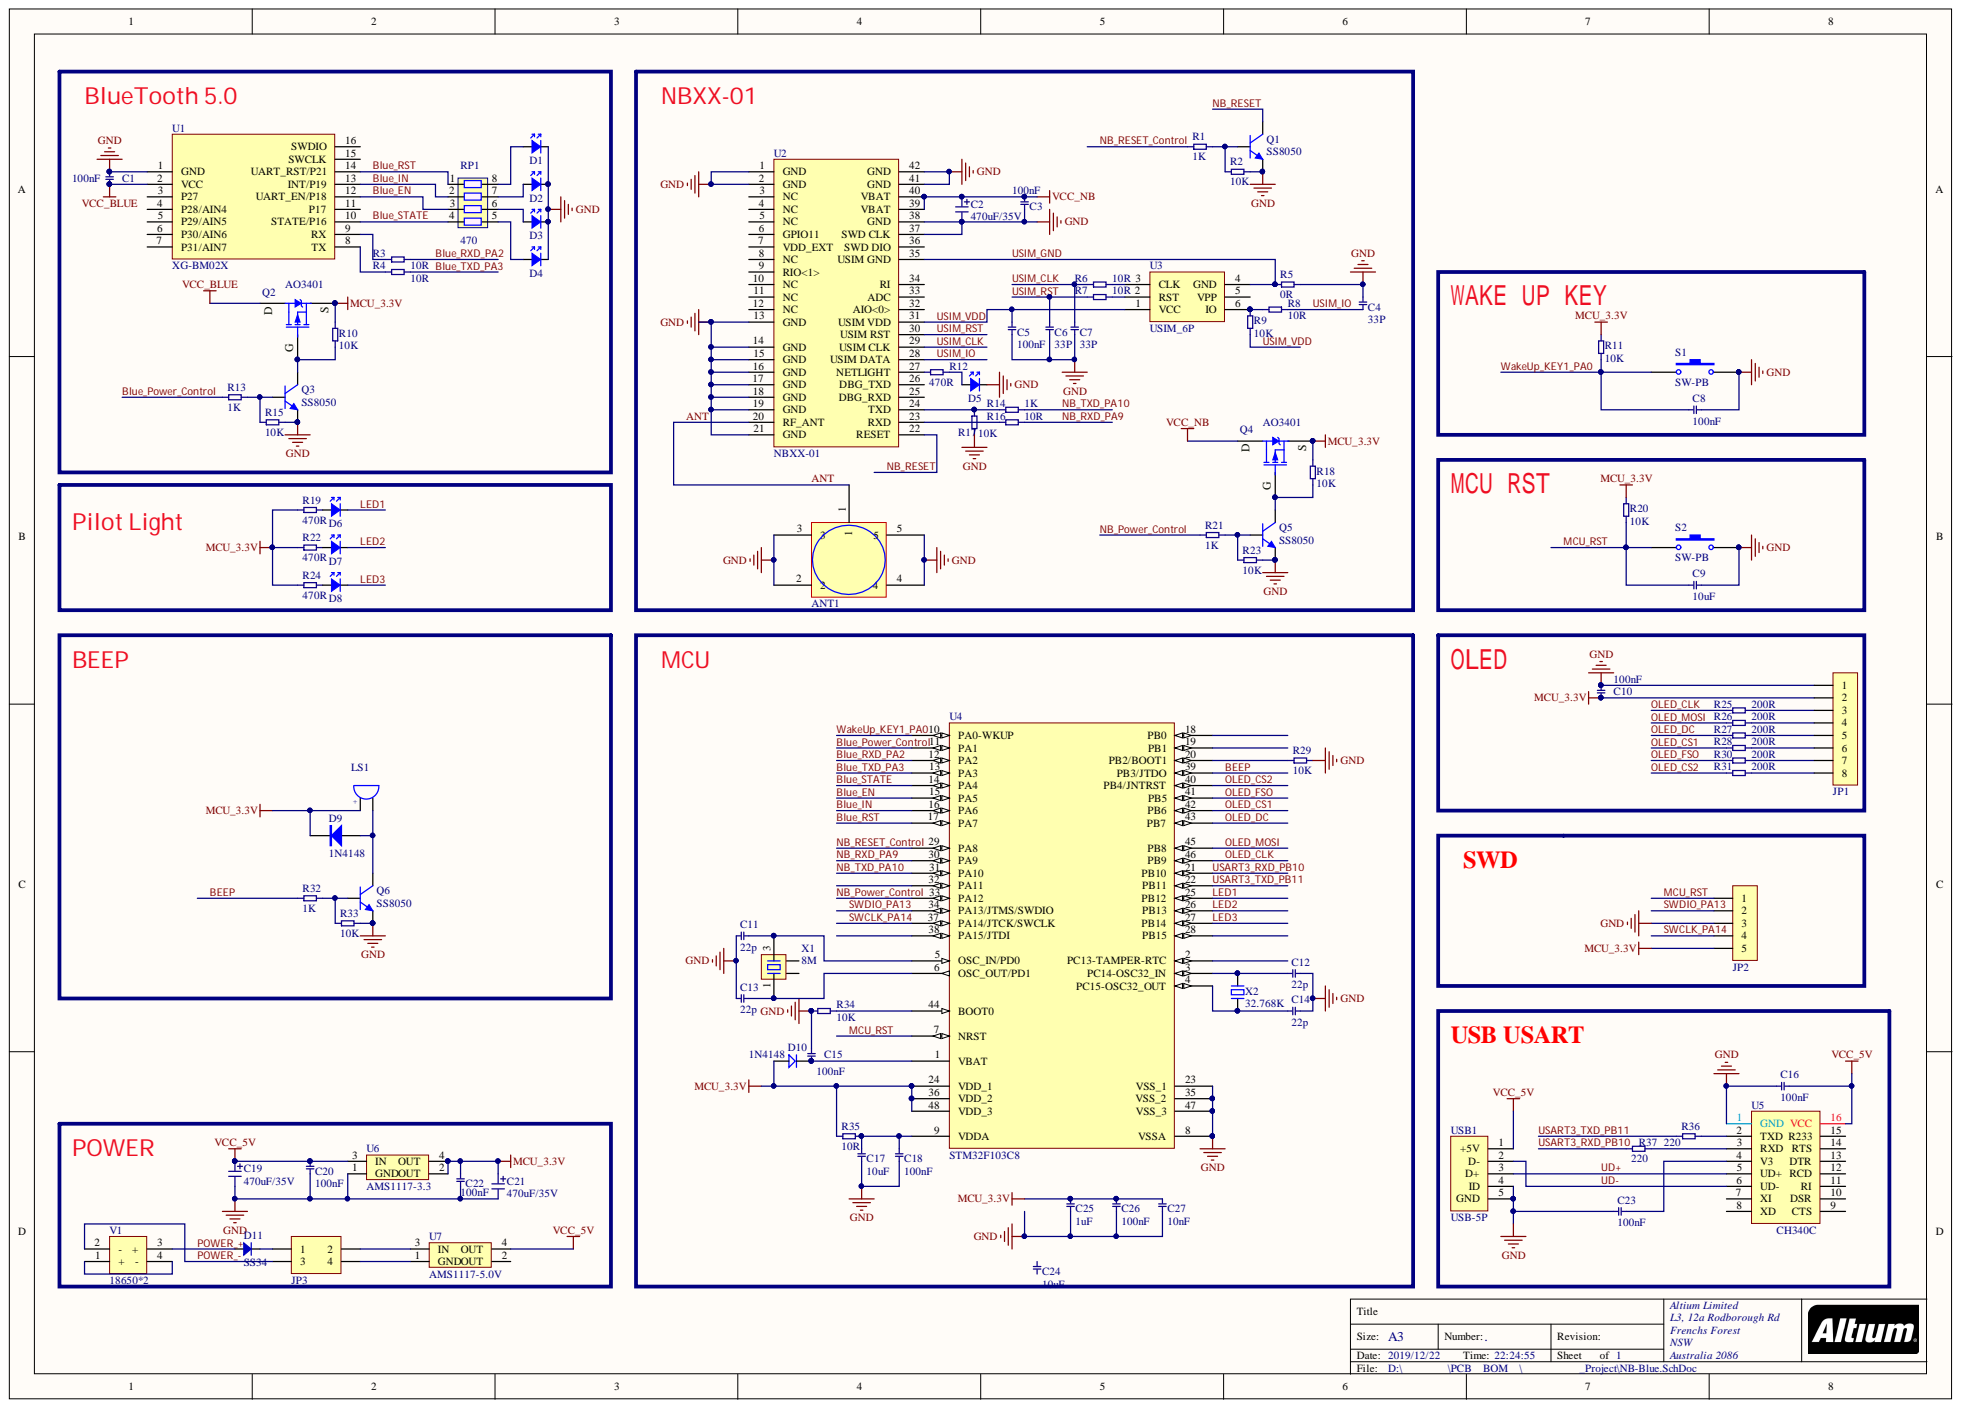
[picture p5: page 1]
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
