luofanzhi/NB_DATA_COLLECT/(list of files, drawings)

Other design files:
Lierda NB-Iot模组资料/NBXX_01标准模组封装.PcbLib
Lierda NB-Iot模组资料/封装/NB05.PcbDoc
Lierda NB-Iot模组资料/封装/NB05_pads.pcb
PCB及BOM表/数据收集器_V2.0/NB-Blue.SchDoc
PCB及BOM表/数据收集器_V2.0/数据收集器_Project.PrjPcb
