luofanzhi/NB_DATA_COLLECT/代码/SLEEPMODE/SleepMode/SleepMode.c

#include "SleepMode.h"
#include "NB.h"
#include "BlueTooth.h"
Sleep_Mode_Typedef Sleep_Mode_Struct;
void Sys_Sleep_Mode(void)
{
	RCC_APB1PeriphClockCmd(RCC_APB1Periph_BKP|RCC_APB1Periph_PWR,ENABLE);	
	PWR_EnterSTOPMode(PWR_Regulator_LowPower,PWR_STOPEntry_WFI|PWR_STOPEntry_WFE);//�ж�ģʽ���¼�ģʽ
	//PWR_EnterSTANDBYMode();
}


void StopMode_GPIO_Config(void)
{
	GPIO_InitTypeDef GPIO_InitStructure;
	RCC_APB2PeriphClockCmd(RCC_APB2Periph_GPIOA|RCC_APB2Periph_GPIOB|\
	RCC_APB2Periph_GPIOC|RCC_APB2Periph_GPIOD|RCC_APB2Periph_GPIOE|RCC_APB2Periph_GPIOF|RCC_APB2Periph_GPIOG||RCC_APB2Periph_AFIO,ENABLE);
//	GPIO_InitStructure.GPIO_Pin = GPIO_Pin_1|GPIO_Pin_12|GPIO_Pin_8;
//	GPIO_InitStructure.GPIO_Mode = GPIO_Mode_IPD;
//	GPIO_InitStructure.GPIO_Speed = GPIO_Speed_2MHz;
//	GPIO_Init(GPIOA,&GPIO_InitStructure);
//	
//	GPIO_InitStructure.GPIO_Pin = GPIO_Pin_1|GPIO_Pin_0|GPIO_Pin_2;
//	GPIO_InitStructure.GPIO_Mode = GPIO_Mode_IPD;
//	GPIO_InitStructure.GPIO_Speed = GPIO_Speed_2MHz;
//	GPIO_Init(GPIOC,&GPIO_InitStructure);
//	
//	
//	GPIO_InitStructure.GPIO_Pin = GPIO_Pin_4|GPIO_Pin_5|GPIO_Pin_6|GPIO_Pin_7|GPIO_Pin_11;
//	GPIO_InitStructure.GPIO_Mode = GPIO_Mode_AIN;
//	GPIO_InitStructure.GPIO_Speed = GPIO_Speed_2MHz;
//	GPIO_Init(GPIOA,&GPIO_InitStructure);

//	
//	GPIO_InitStructure.GPIO_Pin = GPIO_Pin_7|GPIO_Pin_8|GPIO_Pin_9|GPIO_Pin_12|GPIO_Pin_13|GPIO_Pin_14|GPIO_Pin_15;
//	GPIO_InitStructure.GPIO_Mode = GPIO_Mode_IPU;
//	GPIO_InitStructure.GPIO_Speed = GPIO_Speed_2MHz;
//	GPIO_Init(GPIOB,&GPIO_InitStructure);

	GPIO_InitStructure.GPIO_Pin = GPIO_Pin_All;
	GPIO_InitStructure.GPIO_Mode = GPIO_Mode_AIN;
	GPIO_InitStructure.GPIO_Speed = GPIO_Speed_2MHz;
	GPIO_Init(GPIOA,&GPIO_InitStructure);	

	GPIO_InitStructure.GPIO_Pin = GPIO_Pin_All;
	GPIO_InitStructure.GPIO_Mode = GPIO_Mode_AIN;
	GPIO_InitStructure.GPIO_Speed = GPIO_Speed_2MHz;
	GPIO_Init(GPIOB,&GPIO_InitStructure);	
	
	GPIO_InitStructure.GPIO_Pin = GPIO_Pin_All;
	GPIO_InitStructure.GPIO_Mode = GPIO_Mode_AIN;
	GPIO_InitStructure.GPIO_Speed = GPIO_Speed_2MHz;
	GPIO_Init(GPIOC,&GPIO_InitStructure);	
	
	GPIO_InitStructure.GPIO_Pin = GPIO_Pin_All;
	GPIO_InitStructure.GPIO_Mode = GPIO_Mode_AIN;
	GPIO_InitStructure.GPIO_Speed = GPIO_Speed_2MHz;
	GPIO_Init(GPIOD,&GPIO_InitStructure);	
	
	GPIO_InitStructure.GPIO_Pin = GPIO_Pin_All;
	GPIO_InitStructure.GPIO_Mode = GPIO_Mode_AIN;
	GPIO_InitStructure.GPIO_Speed = GPIO_Speed_2MHz;
	GPIO_Init(GPIOE,&GPIO_InitStructure);
	
	GPIO_InitStructure.GPIO_Pin = GPIO_Pin_All;
	GPIO_InitStructure.GPIO_Mode = GPIO_Mode_AIN;
	GPIO_InitStructure.GPIO_Speed = GPIO_Speed_2MHz;
	GPIO_Init(GPIOF,&GPIO_InitStructure);	
	
	GPIO_InitStructure.GPIO_Pin = GPIO_Pin_All;
	GPIO_InitStructure.GPIO_Mode = GPIO_Mode_AIN;
	GPIO_InitStructure.GPIO_Speed = GPIO_Speed_2MHz;
	GPIO_Init(GPIOG,&GPIO_InitStructure);

}
void Sys_Enter_SleepMode(void)
{
	StopMode_GPIO_Config();
	GPIO_SetBits(GPIOB,GPIO_Pin_7|GPIO_Pin_8|GPIO_Pin_9|GPIO_Pin_12|GPIO_Pin_13|GPIO_Pin_14|GPIO_Pin_15);
	
	GPIO_ResetBits(GPIOC,GPIO_Pin_0|GPIO_Pin_1|GPIO_Pin_2|GPIO_Pin_11);
	GPIO_ResetBits(GPIOA,GPIO_Pin_8|GPIO_Pin_1|GPIO_Pin_12);
	
	NB_Power_Control=0;
	BLUE_POWER_CLOSE();
	RCC_APB2PeriphClockCmd(RCC_APB2Periph_USART1,DISABLE);
	RCC_APB1PeriphClockCmd(RCC_APB1Periph_USART2, DISABLE);
	RCC_APB1PeriphClockCmd(RCC_APB1Periph_USART3, DISABLE);
	Sys_Sleep_Mode();	
}
