luofanzhi/NB_DATA_COLLECT/(commit log)

2020-05-02 NB蓝牙集抄器基本功能完成
    [BC95_BLUE拼板.PcbDoc, Data_Blue.SchDoc, MCU.SchDoc, Main_Board.csv, Main_Board.xlsx, NB-Blue.SchDoc, NB05.PcbDoc, NB05_pads.pcb]
2020-05-02 增加git说明文档
2020-05-15 修改文件名
    [BC95_BLUE拼板.PcbDoc, Data_Blue.SchDoc, MCU.SchDoc, Main_Board.csv, Main_Board.xlsx, NB-Blue.SchDoc, main_Project.PrjPcb, 数据收集器_Project.PrjPcb]
